akukulanski/RF_Switch_3GHz/Presentación/RF Switch.pptx

## RF Switch

Carducci, Nahuel
Cinetto, Cristian
Demski, Andres
Kukulanski, Ariel
Paunovic, Iván

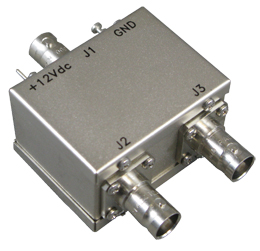
[picture p1: figure]

Medidas Electrónicas 2 - UTN FRBA
13/08/2016

## Índice:

- Descripción del proyecto
- Diodos PIN
- Esquemático
- Simulación
- Desarrollo del PCB

## Descripción del proyecto

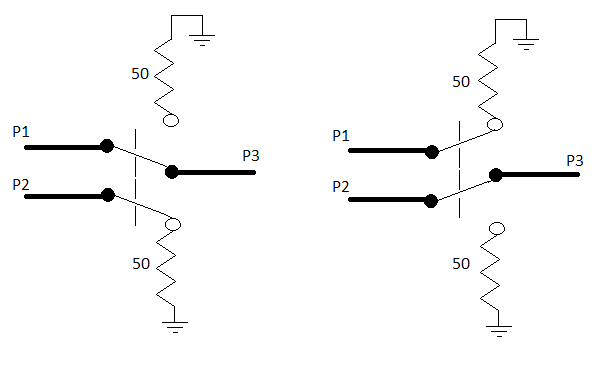
[picture p2: figure]

## Diodos PIN

Curva de Resistencia del diodo pin

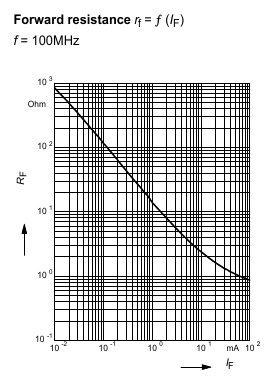
[picture p3: figure]
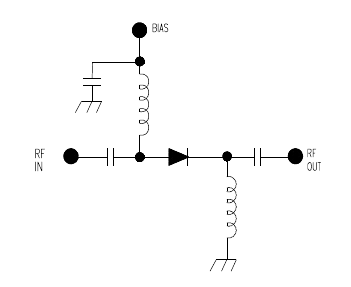
[picture p4: figure]

Circuito de Polarización

## Esquemático

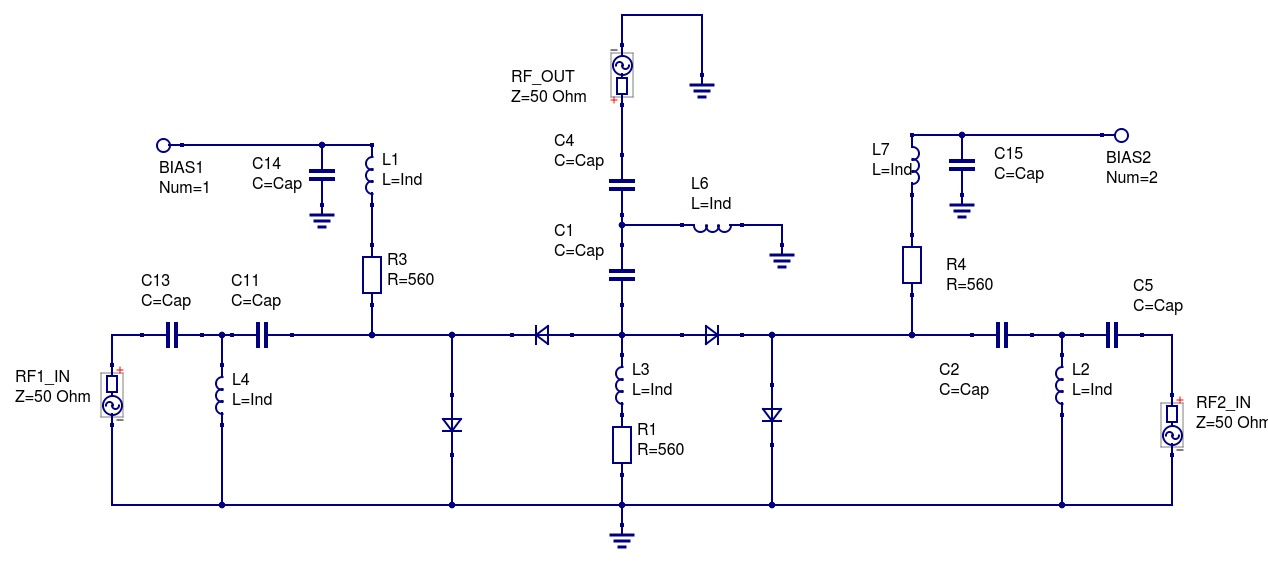
[picture p5: figure]
export

RF IN

50 ohm

RF OUT

## Simulación

Modelo del diodo pin

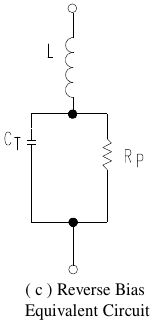
[picture p6: figure]
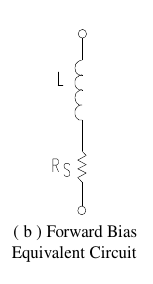
[picture p7: figure]

## Simulación

Valores del diodo PIN BAR64 02V (Infineon)
Rs: 1 ohm ; 50 ohm (polarización)
L: ≈ 1 nHy (despreciable)
Rp: 3 Kohm @ 1.8 Ghz
Ct: 0.17 pF @ 1.8 Ghz

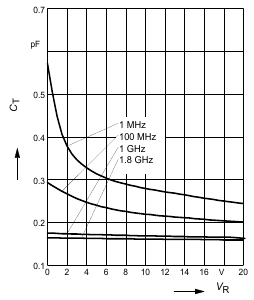
[picture p8: figure]
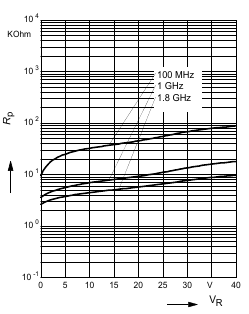
[picture p9: figure]

## Simulación

Resultados:

S11 con puerto 1 desconectado.
Coeficiente de reflexion del puerto que esta desconectado.

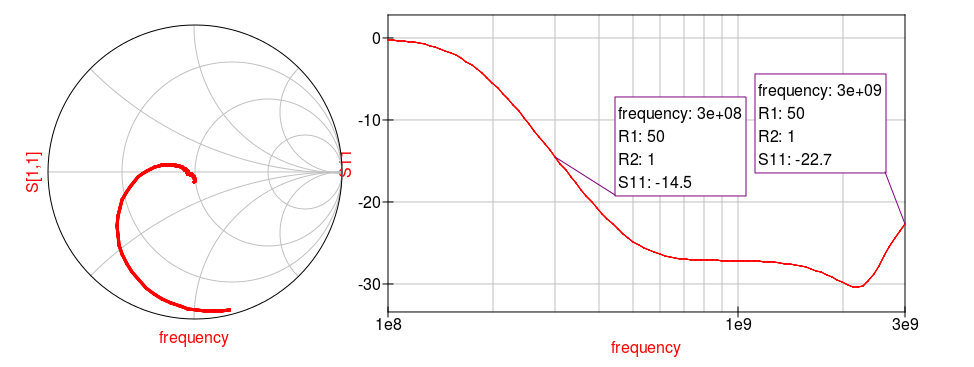
[picture p10: figure]

## Simulación

Resultados:

S22 con puerto 2 conectado.
Coeficiente de reflexion del puerto que esta conectado.

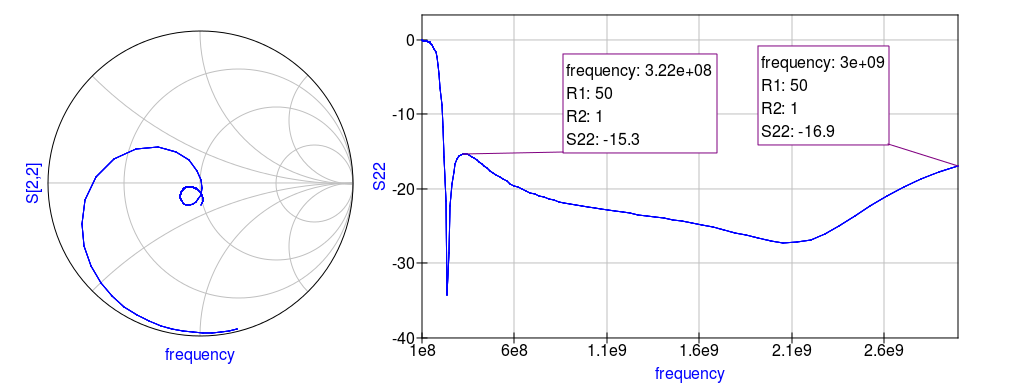
[picture p11: figure]

## Simulación

Resultados:

S31 con puerto 1 desconectado.
Transferencia del puerto que esta desconectado.

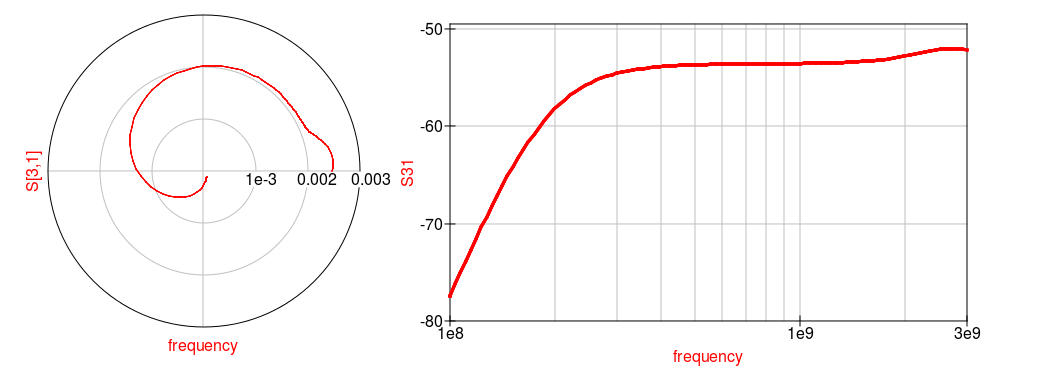
[picture p12: figure]

## Simulación

Resultados:

S23 con puerto 2 conectado.
Transferencia del puerto que esta conectado.

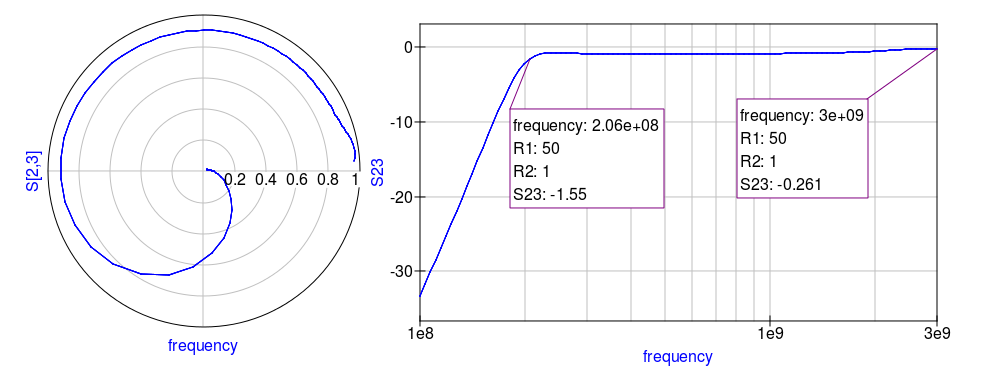
[picture p13: figure]

## Simulación

Resultados:

Coeficiente de reflexion del puerto de salida

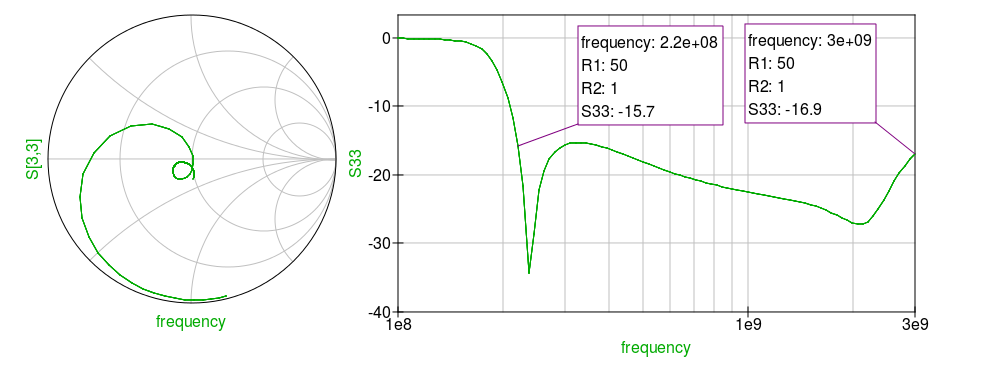
[picture p14: figure]

## Simulación

Resultados:

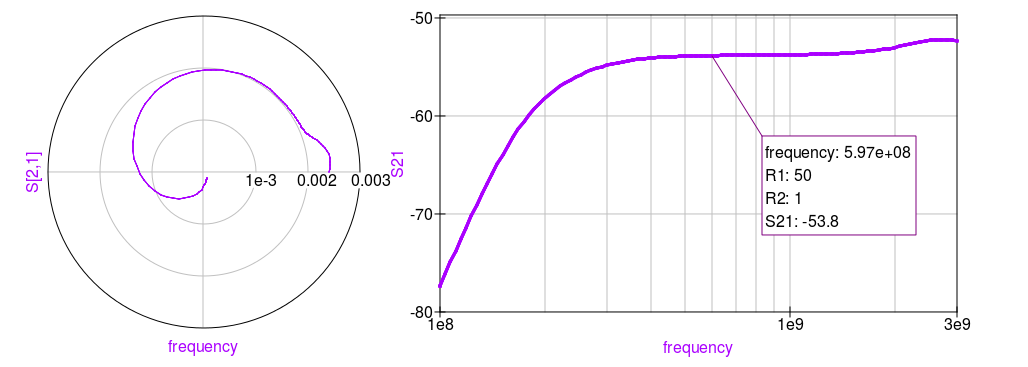
[picture p15: figure]

S21 (Crosstalk)

## Desarrollo PCB-Altium Designer

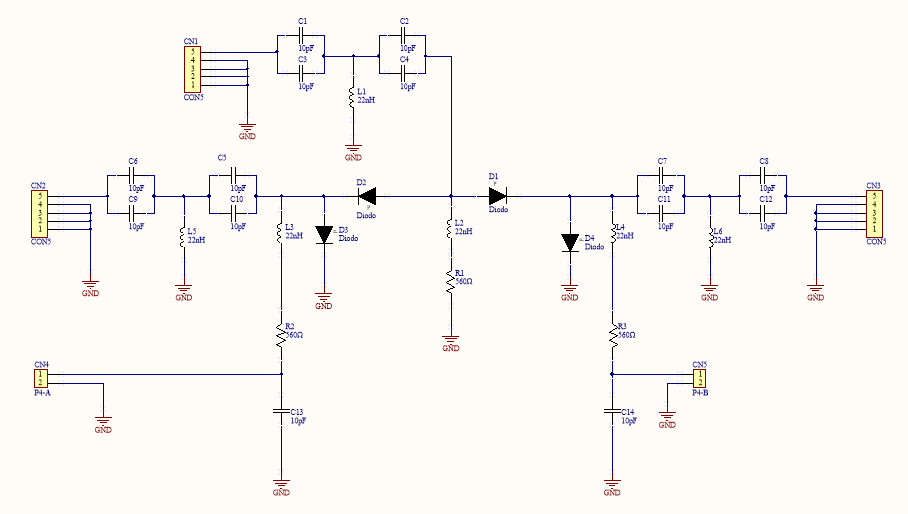
[picture p16: figure]

## Desarrollo PCB-Altium Designer

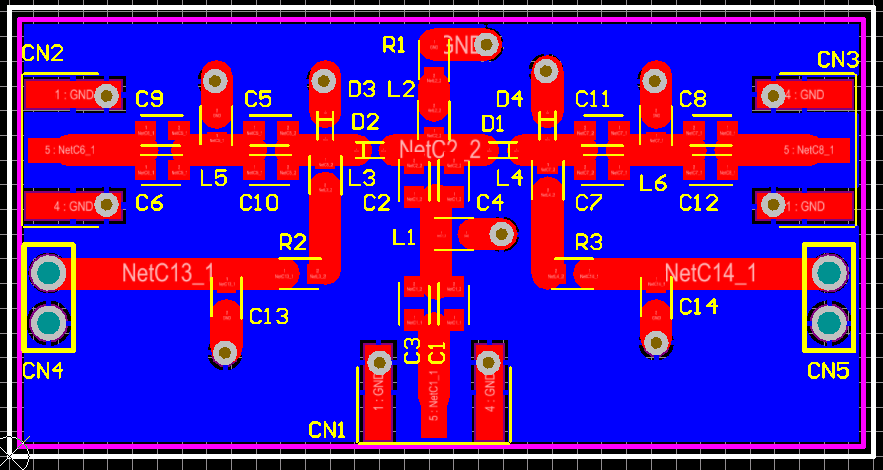
[picture p17: figure]

## Esto es todo amigos!

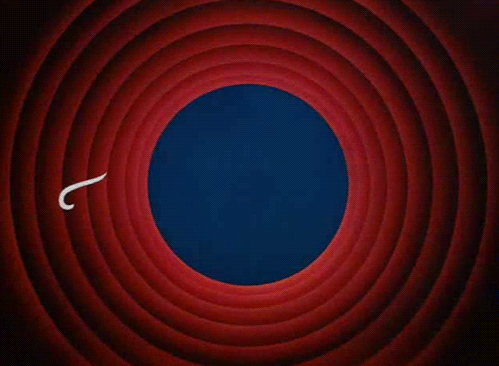
[picture p18: figure]
giphy
