akukulanski/RF_Switch_3GHz/Presentación/informe-rf-switch.pdf

# UNIVERSIDAD TECNOLÓGICA NACIONAL FACULTAD REGIONAL BUENOS AIRES

## Departamento de Electrónica

## Materia: Medidas Electrónicas 2 Proyecto: RF-Switch SPDT con diodos pin

## Docente: Ing. Alejandro Henze

### Ayudante de TP: Ing. Guillermo Monasterios

Grupo N°: 4

Alumnos :

| Apellido y Nombre | Legajo
1 | Carducci, Nahuel | 146.678-1
2 | Cinetto, Cristian | 146.740-2
3 | Demski, Andrés | 146.634-3
4 | Kukulanski, Ariel | 146.771-2
5 | Paunovic, Iván | 146.810-8
Entrega Informe | Fecha | Firma
Primer entrega | 11 / 12 / 16
Aprobación | / / 16
Entrega | Devolución | Re-entrega | Firma Recepción
2° | 15 / 12 / 16 | 16 / 12 / 16
3° | / / 16 | / / 16
4° | / / 16 | / / 16

UTN – FRBA – ME2
Diciembre, 2016

ÍNDICE

Resumen | 2
1. INTRODUCCIÓN | 2
2. DESARROLLO DEL TRABAJO | 3
Principio de funcionamiento | 3
Diseño | 5
Cálculo de la corriente de polarización de los diodos PIN | 5
Diseño del Bias Tee | 5
Diseño de la placa / Layout | 8
Diseño de la fuente de corriente | 10
Modelo matemático | 11
Modelo del diodo pin | 11
Modelo de componentes discretos | 11
Simulaciones | 12
Mediciones Realizadas | 12
Parámetros medidos | 12
Setups de medición utilizados | 13
3. RESULTADOS | 16
4. DISCUSIÓN | 19
5. CONCLUSIONES | 19
6. REFERENCIAS | 19
7. ANEXOS | 21
Tablas con resultados de las mediciones | 21
Señal incidente en puerto 1 - Estado “A” | 21
Señal incidente en puerto 1 - Estado “B” | 22
Señal incidente en puerto 2 - Estado “A” | 23
Señal incidente en puerto 2 - Estado “B” | 24
Señal incidente en puerto 3 - Estado “A” | 25
Señal incidente en puerto 3 - Estado “B” | 26

## RF-Switch SPDT con diodos pin

Carducci N., Cinetto C., Demski A., Kukulanski A. y Paunovic I. Docente a cargo: Henze A., Monasterios G. Universidad Tecnológica Nacional - Facultad Regional Buenos Aires Medidas Electrónicas 2

Resumen
Se diseñó, implementó y caracterizó un switch SPDT disipativo para RF. Para el mismo, se utilizó un circuito basado en diodos PIN, con el cual se obtuvo un ancho de banda del dispositivo de 300 MHz a 3 GHz. El dispositivo fue caracterizado mediante mediciones de parámetros S hechas con un analizador vectorial de redes (VNA) y de su módulo con la utilización de un analizador de espectro (AE).

### 1. INTRODUCCIÓN

Los switches electrónicos tienen varias clasificaciones. En este caso se habla de un switch single pole-double throw (SPDT), lo cual refiere a que un terminal se puede conectar a dos posibles terminaciones distintas (Fig. 1 izq.). En el caso de un double pole - double throw (DPDT) refiere a dos terminales, donde cada uno de ellos puede conectarse en dos terminaciones distintas, y ambas conexiones cambian en forma conjunta (Fig. 1 der.).

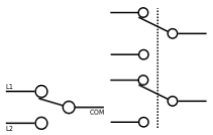
[picture p19: figure]

| Fig. 1: Switch SPDT izquierda, switch DPDT derecha.
| De los switches SPDT, los hay tanto del tipo reflectivo (reflective) y disipativo (absorptive). Los primeros siguen el esquema antes mostrado (Fig. 1 izq.), en el cual el terminal desconectado (L2) queda abierto o en corto, reflejando toda la potencia que se aplique al terminal. En el caso de los disipativos, el puerto desconectado es terminado en la impedancia característica del sistema en el cual esté inmerso (Fig. 2).

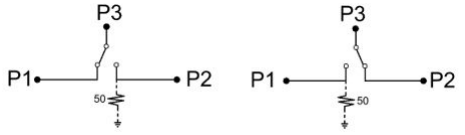
[picture p20: figure]

| Fig. 2: Switch SPDT disipativo.
| También los switches electrónicos pueden clasificarse según la tecnología en que fueron desarrollados. En la Tabla 1 se resumen las características de las principales tecnologías [1]. Este proyecto es realizado utilizando diodos PIN, los cuales al polarizarlos en directa funcionan para RF como una resistencia cuyo valor es controlable con la corriente de polarización, y al ponerlos en inversa

presentan una impedancia alta.

| Basados en diodos PINs | Basados en FETs | Electromecánicos o MEMS
Aislación en alta frecuencia | Mala | Mala | Buena
Frecuencia de corte inferior | ~ 10MHz | Muy baja | Desde DC
Potencia | Alta | Media | Alta
Respuesta | No lineal en bajas frecuencias | Lineal | Muy lineal
Velocidad de conmutación | Rápida | Rápida | Lenta
Consumo de polarización | Alto | Bajo | _
Insertion loss | Medio | Medio | Muy bajo
Redes de polarización | Complejas | Sencillas | No tiene
Ciclos de vida | Alto | Alto | Medio
| Tabla 1: Comparativa de las distintas tecnologías switches.

### 2. DESARROLLO DEL TRABAJO

| Principio de funcionamiento
| El funcionamiento de este switch se basa en la polarización de cuatro diodos PIN (Fig. 3) [2], de forma de obtener dos estados posibles. Uno en el cual el puerto 1 queda conectado al puerto 3, con el puerto 2 presentando la impedancia característica de 50Ω, y el otro en el cual el puerto 2 se conecta al puerto 3, y es el puerto 1 el que presenta 50Ω.

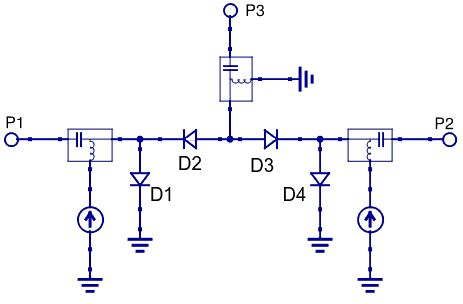
[picture p21: figure]

| Fig. 3: Esquema básico de un SPDT con diodos pin.

Los diodos PIN están formados por tres capas. Una dopada tipo N, una intrínseca, y una dopada tipo P. Tienen la particularidad que al circular por ellos una corriente continua, se acumulan portadores en la capa intrínseca. A partir de cierta frecuencia, la capa intrínseca no llega a desagotarse de portadores, por lo que presenta un comportamiento resistivo. La magnitud de la corriente continua que circule está fuertemente ligada a la cantidad de portadores acumulados, y por lo tanto, a la resistencia que presenta el dispositivo en alta frecuencia. Esta relación se puede ver en la curva que se presenta en la Fig. 4, la cual es parte de la hoja de datos del diodo PIN BAR64-02V [3].
Para polarizar los diodos y al mismo tiempo hacerles circular la RF, es necesario desacoplar las bajas y altas frecuencias entre sí. Esto se logra con un Bias-Tee. El Bias-Tee es una red de tres puertos (RF, CC, RF+CC) que permite aislar entre sí los puertos de señal (RF) y corriente continua (CC). El esquema más básico consiste en un inductor y un capacitor de acople (Fig. 5). El capacitor funciona como un cortocircuito para la señal de RF, y un circuito abierto para la continua, mientras que el inductor funciona como circuito abierto para la RF, y como cortocircuito para la continua.

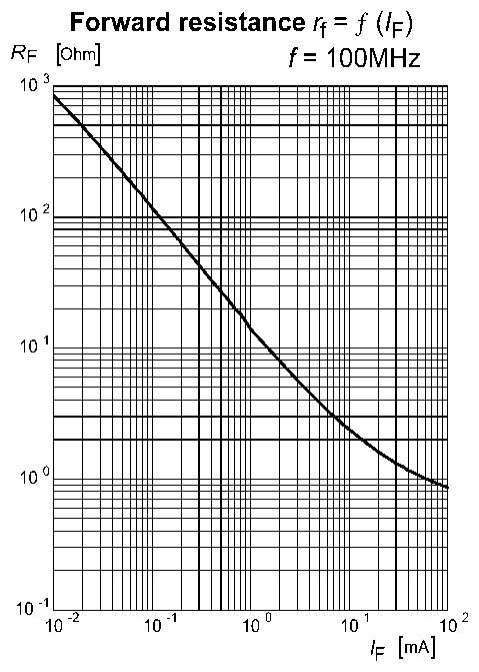
[picture p22: figure]

| Fig. 4: Curva de Resistencia vs Corriente del diodo PIN BAR64-02V [3].

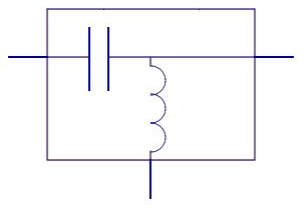
[picture p23: figure]

| Fig. 5: Bias-Tee.
| El primer caso (P1 conectado a P3) se logra polarizando el diodo que une los puertos 1 y 3 (D2) de forma que presente una resistencia lo más baja posible. Los diodos D1 y D3 deben quedar en inversa para conseguir una resistencia lo maś alta posible. El diodo D4 es en este caso el encargado de presentar los

50Ω al puerto 2. El segundo caso (P2 conectado a P3) se logra invirtiendo los roles entre D2 y D3, y entre D1 y D4.

Diseño
Cálculo de la corriente de polarización de los diodos PIN
Para el diseño se utiliza el diodo BAR64-02V. De su curva de resistencia en función de la corriente directa (Fig. 4), se obtienen los valores de corriente con los que se logran las condiciones planteadas anteriormente.
Para obtener un bajo Insertion Loss, se elige una corriente de 20 mA, con la cual la resistencia en alta frecuencia es de 1,3 Ω. Para lograr una resistencia de 50 Ω, la corriente directa es de 250 µA. Para establecer una alta aislación, basta con polarizar el diodo en inversa. Se observa que la resistencia en inversa está siempre por encima de 2,5 KΩ (Fig. 6), suficiente para el diseño que se plantea.

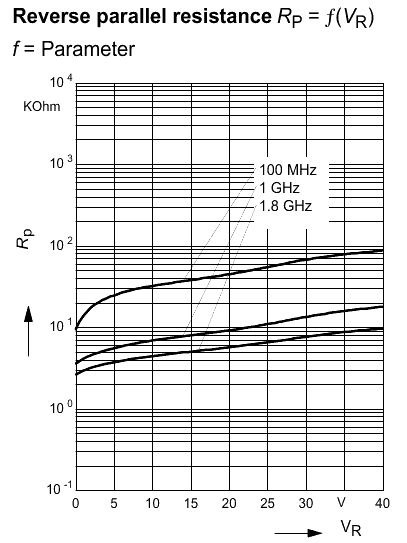
[picture p24: figure]

| Fig. 6: Resistencia del diodo BAR64-02V en función de su tensión inversa [3].
| Diseño del Bias Tee
| Para un correcto funcionamiento, el puerto de RF debe presentar una impedancia baja en la banda de funcionamiento del dispositivo, y una alta en continua. Como primera aproximación, si se quiere una reactancia capacitiva menor a 1 Ω a 300MHz, la capacidad deberá ser mayor a 530 pF. Y si se quiere una reactancia inductiva de al menos 1 KΩ a esa misma frecuencia, el inductor será como mínimo de 530 nH. Estos valores son factibles para anchos de banda no muy grandes, pero si se busca que sea de al menos una década (300 MHz a 3 GHz), resulta complicado conseguir componentes que tengan una frecuencia de autoresonancia mayor a los 3 GHz. Por ejemplo, el inductor LQW18ANR47J00D de Murata [5] tiene un valor de 470 nH, pero su frecuencia de resonancia es de 700 MHz. Ante esta situación se resuelve, en vez de usar un único inductor, utilizar varios de distintos valores en cascada, a los que se les reduce el factor de mérito por medio de una resistencia en paralelo, de forma de mantener un valor de impedancia mínimo en la banda de trabajo del switch. Utilizando TINA® como herramienta de simulación, se obtuvieron las impedancias para distintas configuraciones posibles, utilizando como modelo del inductor un tanque LC paralelo que contempla la capacidad parásita. En la Fig. 7 se muestra el módulo y la fase de la impedancia para un inductor de 470 nH que resuena a 700 MHz (violeta), y uno de 22 nH que resuena a 3 GHz (azul). El inductor de 470 nH sólo no sirve, por tener una reactancia capacitiva a partir de los 700 MHz. El inductor de 22 nH sólo tampoco sirve, por tener una muy baja impedancia en frecuencias por debajo de 1 GHz. Si se conecta ambos inductores en serie, existe una zona en donde la reactancia inductiva del de 22 nH se anulará con la reactancia capacitiva del de 470 nH, generando un valle en el módulo de impedancia. La solución es empeorar el factor de calidad de ambos inductores, forzando que la impedancia cerca de la resonancia esté dominada por el elemento resistivo agregado [4]. El efecto de las resistencias se muestra en la Fig. 8, en donde se grafica la impedancia de los dos inductores mencionados en serie sin resistencias adicionales (marrón), y con resistencias de 1 KΩ en paralelo a cada uno (verde). Se observa que agregando las resistencias, entre 300 MHz y 3 GHz se mantiene una impedancia por encima de 500 Ω, siendo esta inductiva entre 300 MHz y 700 MHz, y predominantemente resistiva (o ligeramente capacitiva) entre 700 MHz y 3 GHz.

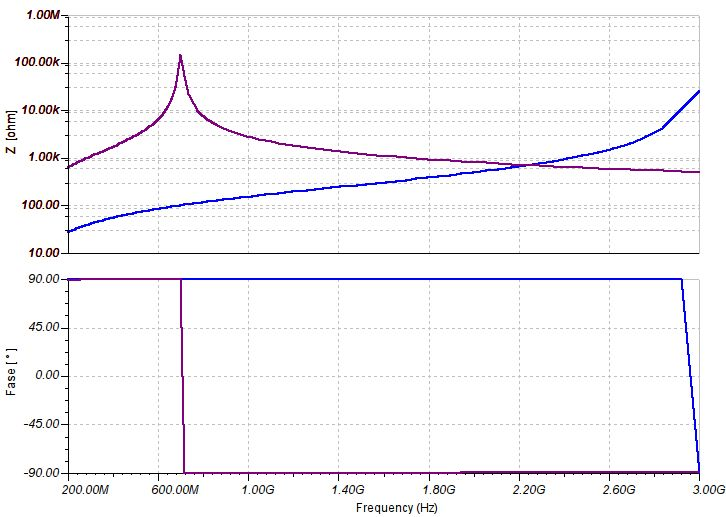
[picture p25: figure]

| Fig. 7: Impedancia de inductor de 470 nH con resonancia en 700 MHz (violeta) y de inductor de 22 nH con resonancia en 3 GHz (azul)

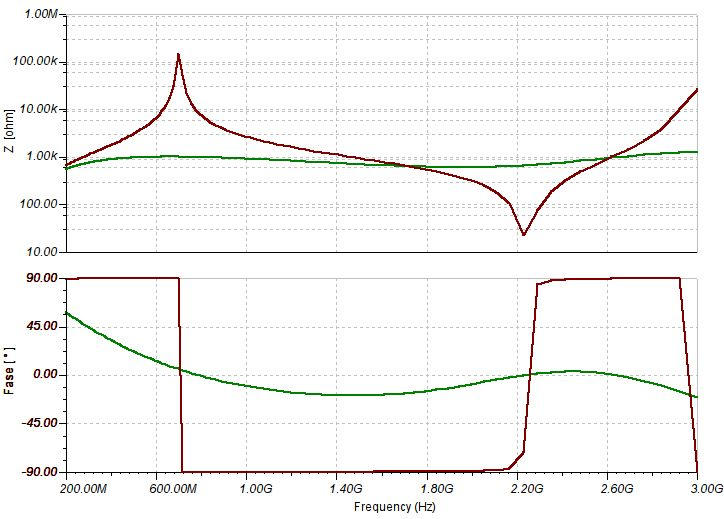
[picture p26: figure]

| Fig. 8: Impedancia de inductores de 470 nH y 22 nH en serie sin (marrón) y con (verde) resistencias de 1 KΩ en paralelo a cada uno.
| Para evitar la autoresonancia de los componentes antes de los 3 GHz, se basa el diseño en capacitores de 10 pF, en lugar de los 530 pF planteados originalmente. Dada su baja reactancia a 300 MHz, se utilizan de a pares conectados en paralelo, formando 20 pF. Dado que los 20 pF siguen teniendo una respuesta mala en 300 MHz (reactancia de 26,5 Ω), se procede a realizar un filtro que mejora la adaptación, utilizando los componentes disponibles. El filtro es un pasaaltos que consta de dos capacidades y una inductancia, dispuestos en forma “T” como se muestra en la figura 9 (b). La respuesta del filtro se obtuvo a partir de una simulación con QUCS y se muestra en la figura 10, donde se lo compara con la del capacitor sólo.

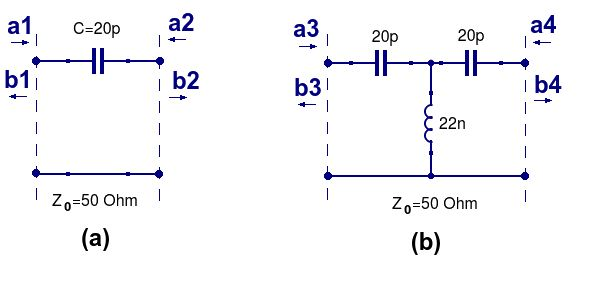
[picture p27: figure]

| Fig. 9: (a) acople con capacitor de 20 pF. (b) acople con filtro T

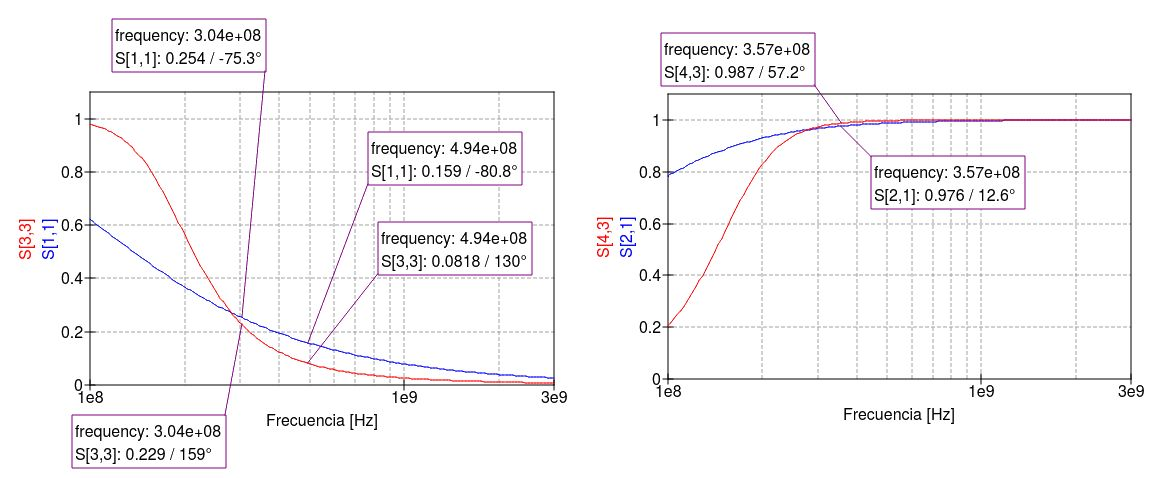
[picture p28: figure]

| Fig. 10: Parámetro de reflexión (a) y de transmisión (b) para ambos acoples. En azul los parámetros con el capacitor, y en rojo los parámetros con el filtro T.
| Diseño de la placa / Layout
| Para el diseño del circuito impreso se debe tener en cuenta el ancho de la traza para evitar desadaptaciones. En baja frecuencia esto no es un problema pero en alta frecuencia, donde la longitud de onda tiene un valor más cercano a las dimensiones de la pista, es importante que la impedancia característica de la línea sea lo más cercana posible a la del generador y la carga para disminuir las reflexiones y así bajar la ROE. La impedancia característica de la línea depende de varios factores, como el ancho de la traza, el espesor del sustrato utilizado para hacer el pcb y su permeabilidad eléctrica. La placa se realizó utilizando un sustrato RO4350B™ [6] de un espesor de 0,76mm. Para el ruteo se optó por una línea tipo microstrip con impedancia característica de 50 Ω (Fig. 11).

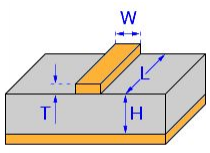
[picture p29: figure]

| Fig. 11: Esquema de un microstrip [QUCS].
| Para conseguir esta impedancia el ancho de la pista fue de 1.63mm , valor que fue verificado con TX-LINE y QUCS. Además de elegir el ancho de la traza, se tuvo en consideración lo siguiente:
| ● Se hizo la placa lo más chica posible ● Se utilizaron componentes 0603 para las resistencias, capacitores e inductores ● Se utilizaron 3 conectores SMA para las dos entradas y la salida de la señal ● Se utilizaron diodos PIN con encapsulado SC79 (su tamaño es de aproximadamente 1.6mm x

0.85mm)
| ● Se utilizó un conector con pines hembra para conectar las fuentes de polarización ● Se hizo un plano de masa por debajo del PCB y se agregaron vías para hacer contacto directo con

el plano de masa
| ● Las trazas se hicieron lo más rectas posible, sin curvatura

La placa finalizada se muestra en la Fig. 12 donde se puede apreciar el signal path recto entre los puertos P1 y P2, y el camino a 90° en forma de “L” entre los puertos P1-P3 y P2-P3. También se observa un conector de pines hembra para conectar las fuentes de polarización.

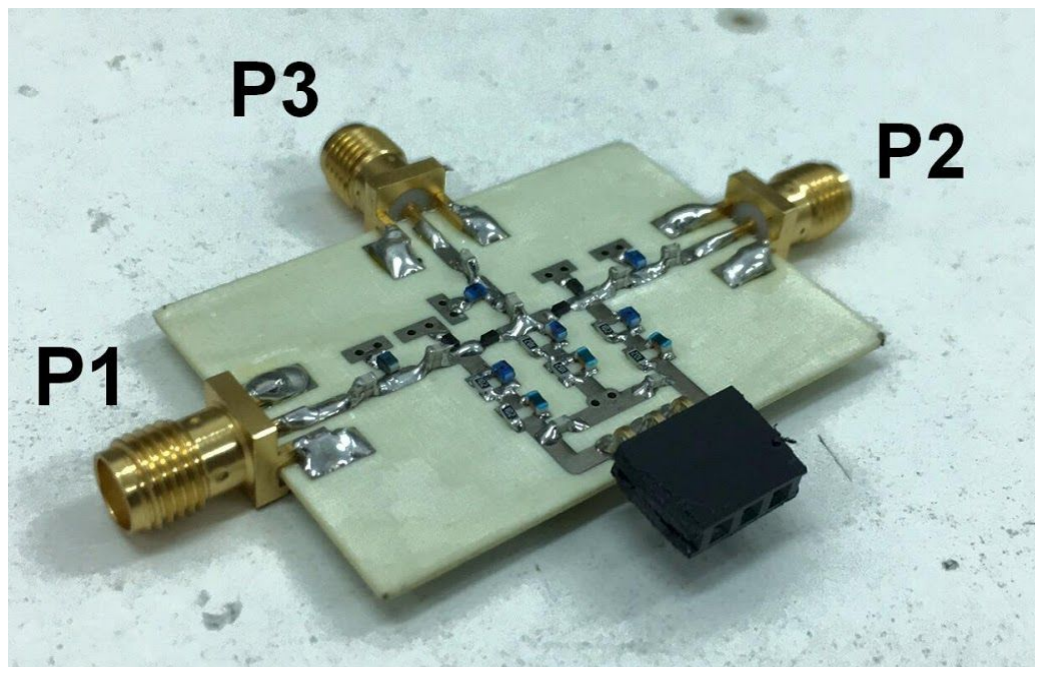
[picture p30: figure]
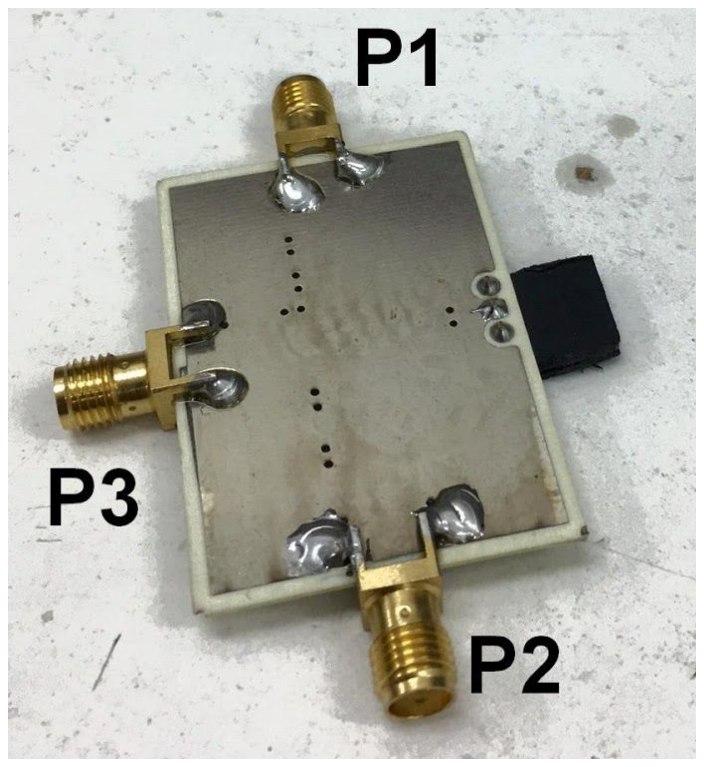
[picture p31: figure]

| Fig. 12: Fotos de la placa finalizada.
| Los componentes utilizados se encuentran en la Tabla 2.

cant | | Marca / Código | Características relevantes
3 | Conector SMA hembra | RS Pro - R19-070-01-0032210LL [7] | 0~18 GHz,
3 | Inductor 470 nH | Murata - LQW18ANR47J00D [5] | f0 = 700 MHz
6 | Inductor 22 nH | TE Connectivity - 36501J22NJTDG [8] | f0 =3 GHz
14 | Capacitor 10 pF | Kemet - C0603C100J5GACTU [9] | Encapsulado 0603, Dieléctrico C0G
6 | Resistor 1 KΩ | - sin datos - | Encapsulado 0603
4 | Diodo PIN | Infineon BAR 64-02V [3] | 1 MHz~6GHz
| Tabla 2: Componentes utilizados

Diseño de la fuente de corriente
| Para polarizar el dispositivo, se realizó un circuito que consiste en dos fuentes de corrientes, las cuales se conmutan manualmente mediante una llave. Como se menciona anteriormente, se usa una corriente de 20 mA para obtener una baja resistencia, y una de 250 µA para obtener 50 Ω. En la figura 13 se muestra el circuito equivalente de DC, polarizado para conectar el puerto 1 al 3, y presentando 50 Ω en el puerto 2. Se observa que para polarizar el diodo D2 con 20 mA, es necesario un potencial Va menor al de masa, dejando a D1 en inversa. Lo mismo ocurre con D3 y D4: para hacer circular corriente por D4, el potencial Vb será mayor a masa, dejando a D3 en inversa. Esto permite polarizar los diodos utilizando sólo dos fuentes de corriente. La conmutación del switch se logra conmutando las fuentes

de corriente.

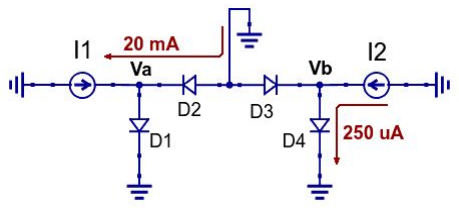
[picture p32: figure]

| Fig. 13: Circuito equivalente de continua.
| La implementación de las fuentes de corriente se encuentran en la Fig. 14. La fuente de 20 mA se realizó con el MOSFET canal N 2N7000 en el cual, mediante un regulador de tensión y un preset, se puede ajustar la corriente de drenaje. La fuente de 250 µA se realizó con dos transistores pnp BC327 en configuración espejo con emisor degenerado. También se fija la corriente por medio de un regulador de

tensión y un preset.

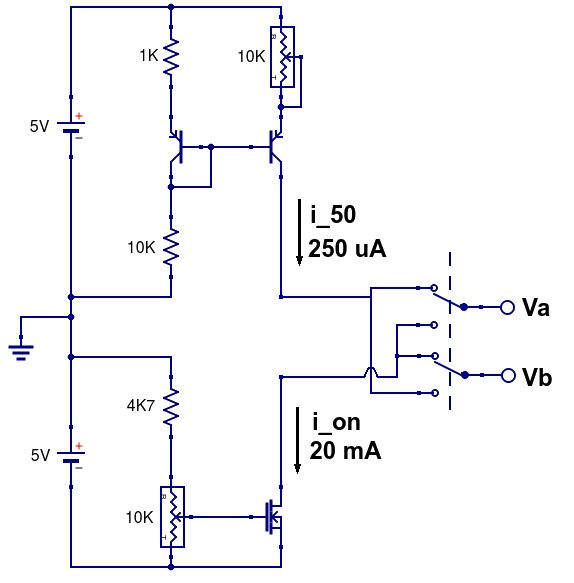
[picture p33: figure]

| Fig. 14: Fuentes de corriente para polarizar los diodos PIN.

Modelo matemático
Modelo del diodo pin
| El modelo del diodo pin en alta frecuencia consiste en una resistencia en paralelo con un capacitor. Al polarizarlo en directa, la resistencia es lo suficientemente baja como para despreciar la capacidad. Los modelos equivalentes para las distintas polarizaciones se muestran en la figura 15.

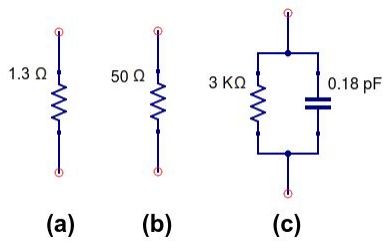
[picture p34: figure]

| Fig. 15: Modelo equivalente del diodo pin en alta frecuencia polarizado en directa con (a) 20 mA, (b) en directa con 250 µA y (c) en inversa.
| Modelo de componentes discretos
| Los resistores y capacitores se asumen ideales por no tener una hoja de datos para modelizarlos. Los inductores, en cambio, se los modeliza con su capacidad paralela parásita, responsable de la autorresonancia del componente. El inductor de 22 nH resuena en 3 GHz, y el de 470 nH en 700 MHz. Los modelos equivalentes de los inductores se muestran en la Fig. 16.

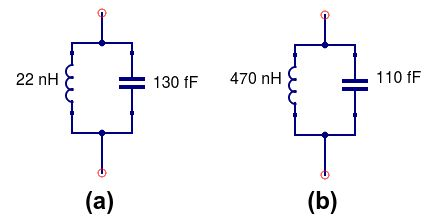
[picture p35: figure]

| Fig. 16: Modelo equivalente de inductor de (a) 22 nH y (b) 470 nH.

Simulaciones
| Se realizaron simulaciones de los parámetros S con el programa QUCS. En este se tuvieron en consideración los modelos aclarados en la sección anterior. El circuito completo simulado se encuentra en la

Fig. 17. Los resultados de los parámetros simulados se encuentran junto a las mediciones para poder compararlas.

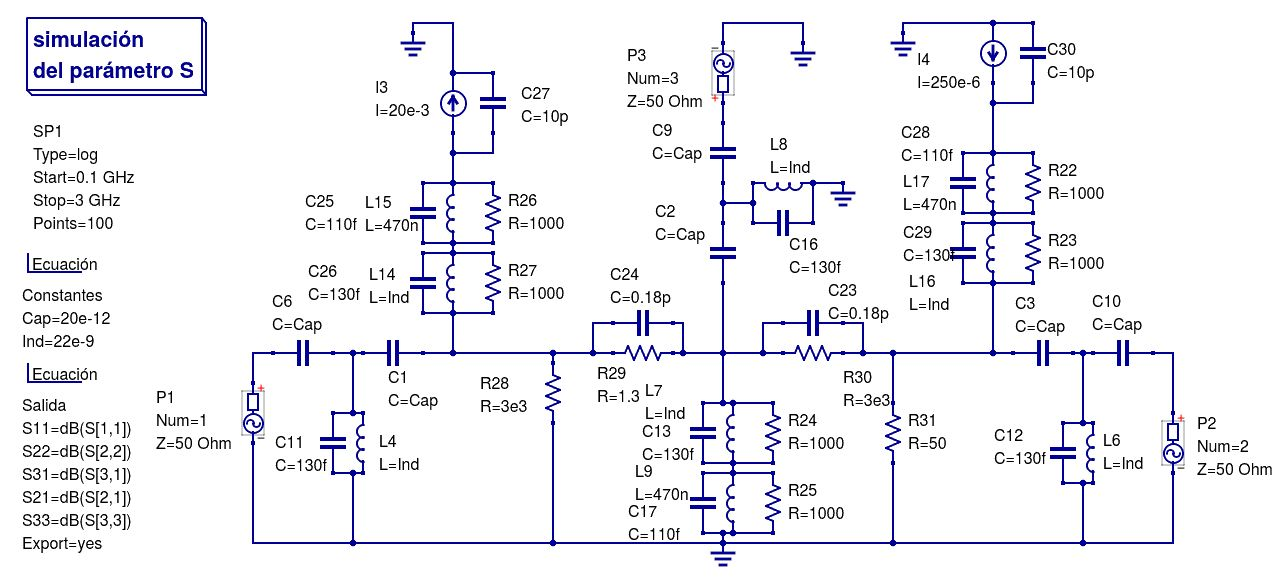
[picture p36: figure]

| Fig. 17: Circuito simulado

Mediciones Realizadas
Parámetros medidos
| Por ser una red de tres puertos, la matriz de parámetros Scattering que caracteriza el switch es de 3x3. A esto se le suma el hecho de que tiene dos estados posibles según a qué puerto se haya conectado el puerto 3, a los que se referirá en el informe como estado “A” y estado “B”. El estado “A” corresponde a conectar el puerto 1 con el 3, y cargar el puerto 2 con 50 Ω, mientras que el estado “B” corresponde a conectar el puerto 2 con el 3, y cargar el puerto 1 con 50 Ω. Para una caracterización completa, la medición consiste en la obtención de 18 parámetros (9 para cada estado posible), tal como se muestra en la Fig. 18.

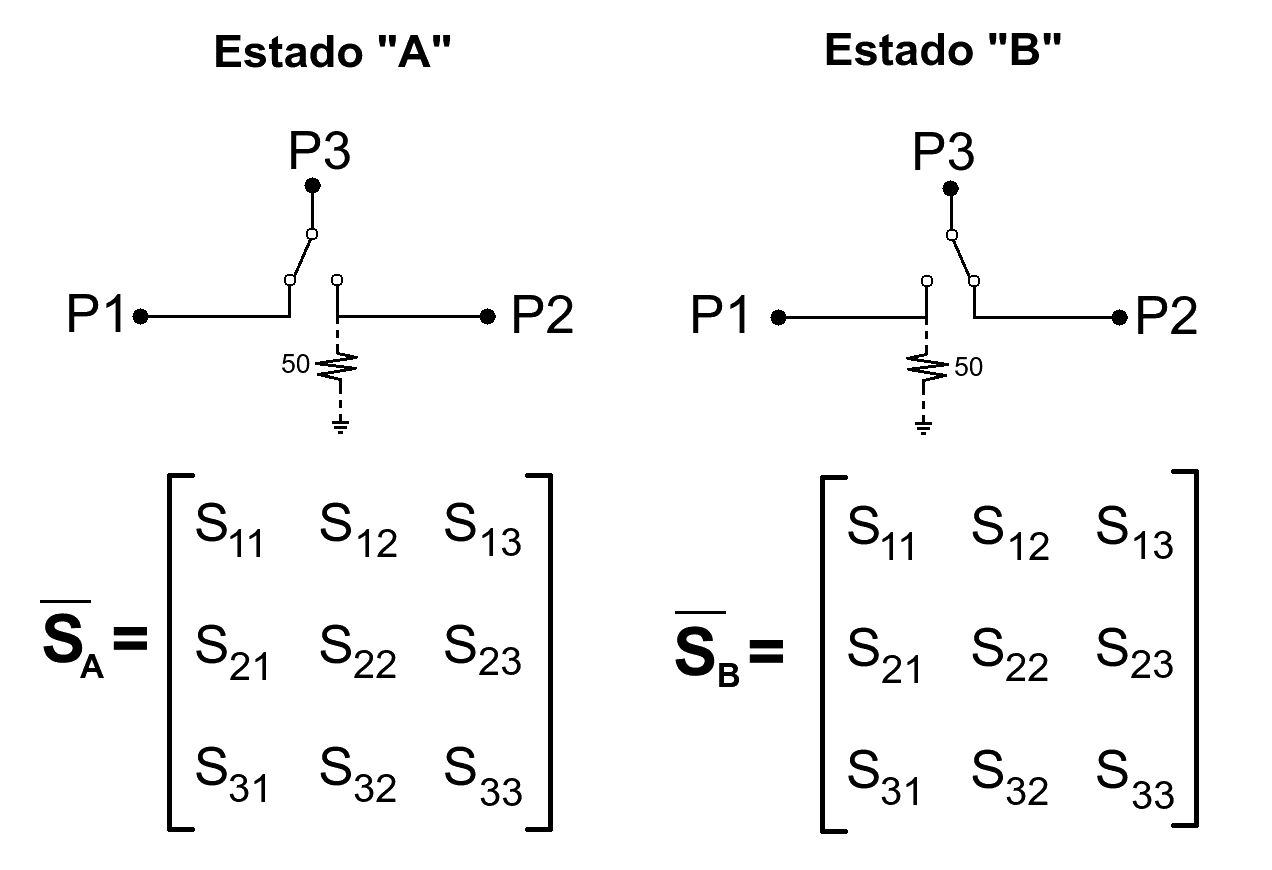
[picture p37: figure]

| Fig. 18: Matrices S para los estados “A” y “B” del switch
| Por ser muy extensa, la información completa de las mediciones se encuentra en el anexo donde, además, se la compara con los valores simulados.
| Setups de medición utilizados
| Las mediciones de los parámetros S del dispositivo se realizaron con dos setups distintos. El primer setup de medición es el VNA que se encuentra en la facultad, realizado con instrumentos de laboratorio comunes [10] (Fig. 19). En este setup (Fig. 20) la señal es aplicada con un generador de RF (Agilent N9310A), la cual con un power splitter es dividida, parte a un canal del osciloscopio (Agilent DSO9254A) donde se mide la onda incidente y parte a la entrada de un acoplador direccional (Agilent 86205A). La salida del acoplador direccional se conecta al DUT, y la salida del acoplador con la onda reflejada es amplificada y conectada a un segundo canal del osciloscopio. La salida del DUT se la conecta al tercer canal del osciloscopio. Se usa un modelo de corrección de errores One Path - Two Ports . Se realizaron mediciones de los parámetros en dos días distintos, haciendo en cada una de ellas la respectiva calibración. En la primera de ellas se aplicó un nivel de señal algo bajo (0 dBm), y no se lograron medir parámetros como crosstalk y aislación debido al rango dinámico limitado del osciloscopio. En la segunda medición, se aplicó una señal de 13 dBm, y se lo pudo medir correctamente.

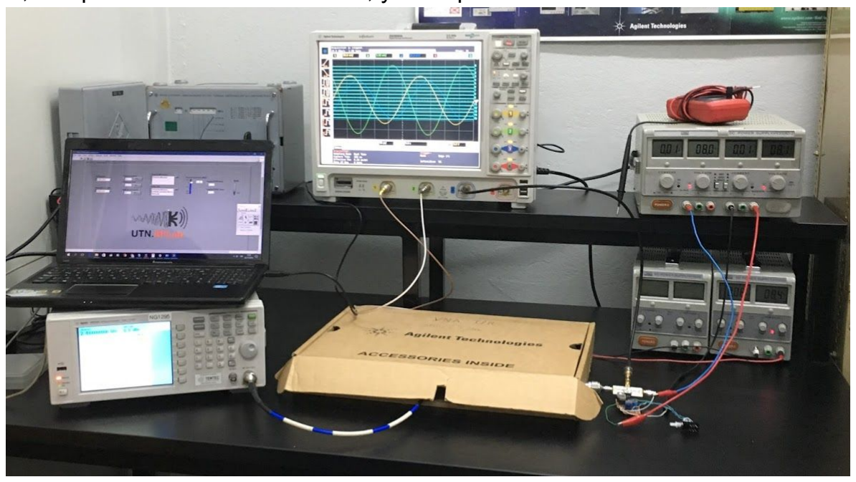
[picture p38: figure]

| Fig. 19: Setup de la medición realizada con VNA.

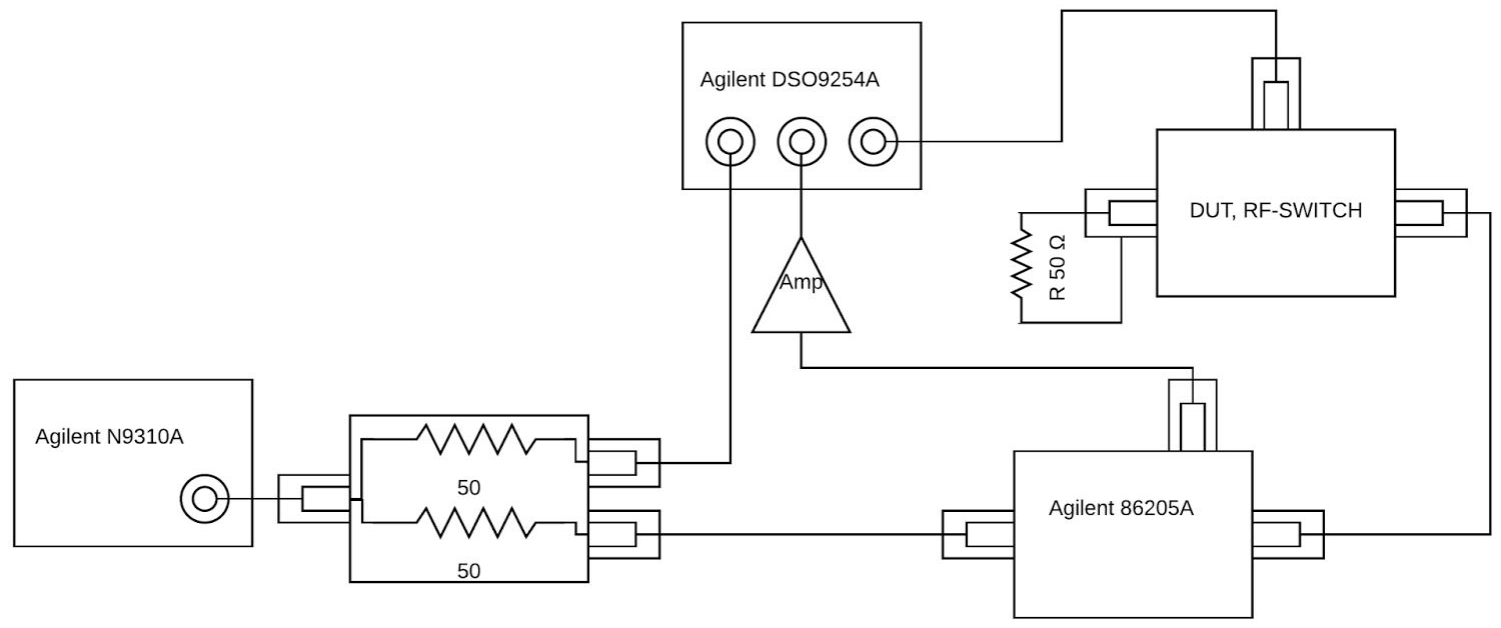
[picture p39: figure]

| Fig. 20: Diagrama en bloques del setup medición con VNA.
| El segundo setup utilizado permite medir el módulo de los parámetros S del sistema (Fig. 21). Este consiste de un analizador de espectro (Agilent N9320A) y un acoplador direccional (Agilent 778D), utilizándose además el tracking generator del primero. El setup tiene dos configuraciones, según se miden parámetros de transmisión o de reflexión. En el primer caso (Fig. 22) se aplica señal con el tracking generator en el puerto de entrada del DUT y se mide en el puerto usado como salida. Para calibrar, se realiza primero un through y se normaliza la escala del AE respecto a esta medición. En el segundo caso (Fig. 23), se aplica señal con el tracking generator a la entrada acoplador direccional, la salida de este se conecta al puerto usado como entrada del DUT, y la salida que acopla la reflejada se conecta a la entrada AE. Para calibrar, se usa un cortocircuito y un circuito abierto conectados en el lugar del DUT, los cuales producen una reflexión total pero con fases contrarias. Las curvas medidas por el AE fueron exportadas en ambos casos, y se utiliza el promedio de ambas como curva de normalización (Fig. 24).

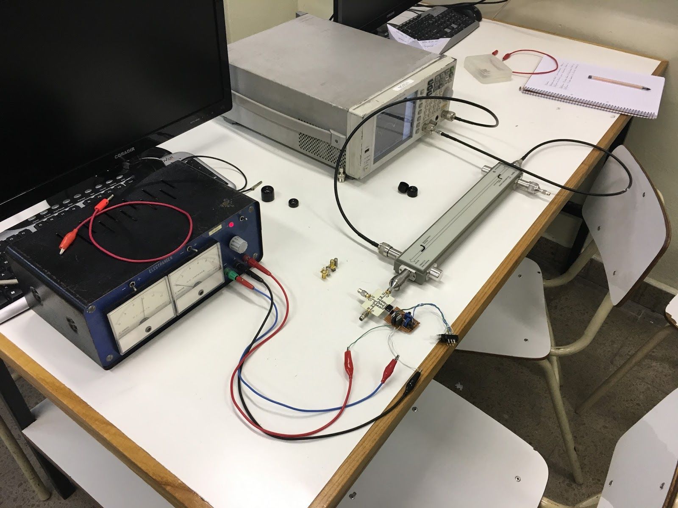
[picture p40: figure]

| Fig. 21: Setup de medición con AE y acoplador direccional.

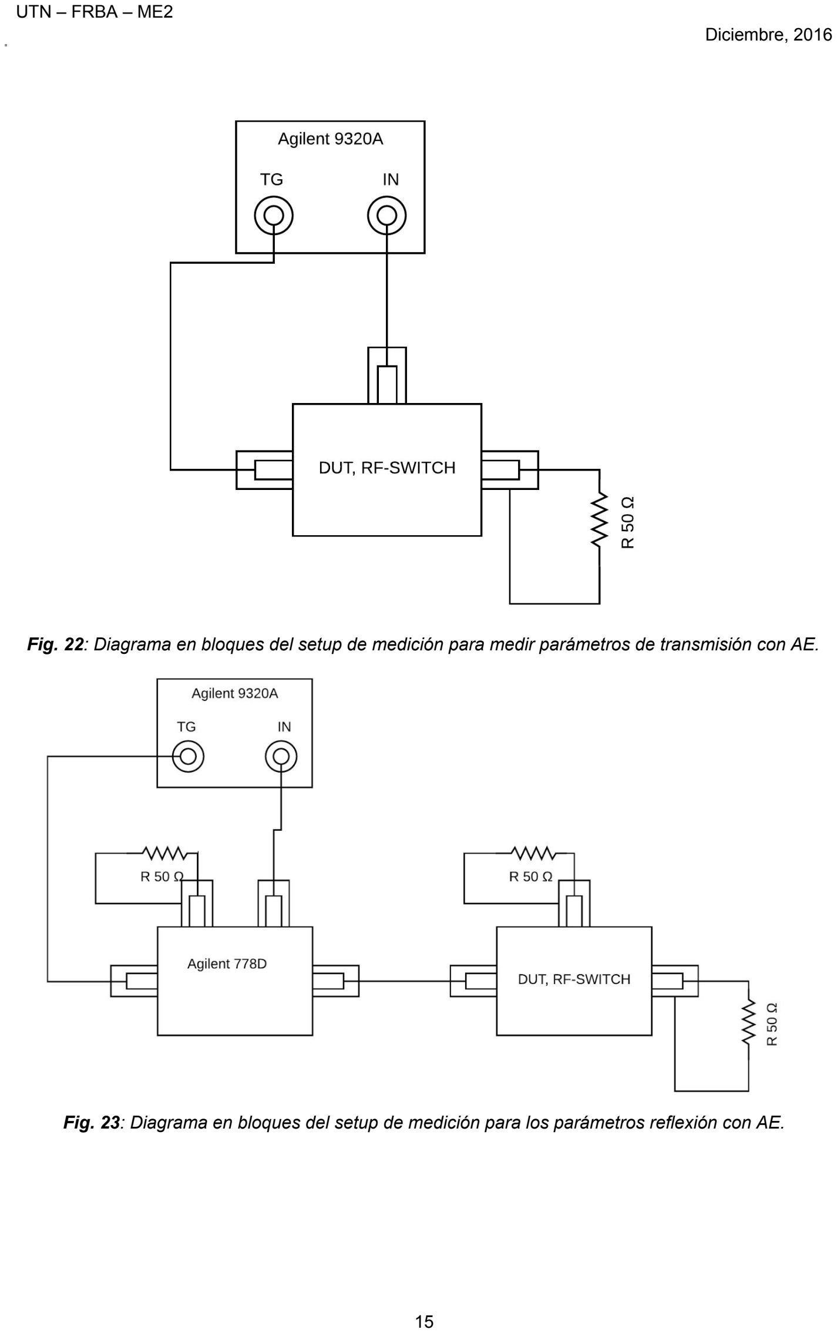
[picture p41: page 16]

| Fig. 22: Diagrama en bloques del setup de medición para medir parámetros de transmisión con AE.
| Fig. 23: Diagrama en bloques del setup de medición para los parámetros reflexión con AE.

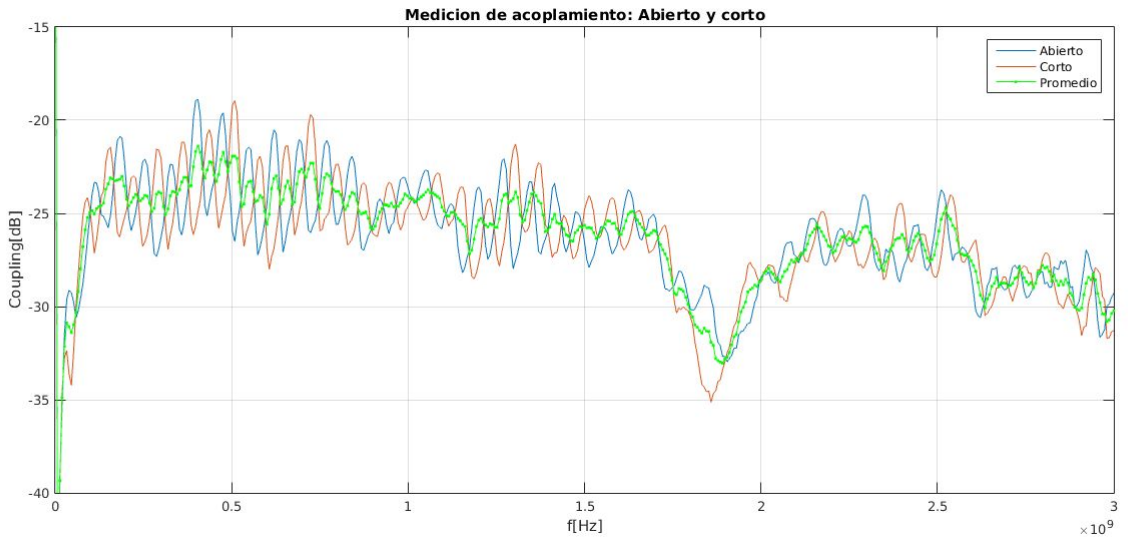
[picture p42: figure]

| Fig. 24: Resultado de la medición del acoplamiento con cortocircuito y circuito abierto

### 3. RESULTADOS

| En esta sección se presentan los gráficos más relevantes de los resultados de las mediciones realizadas junto con los de las simulaciones, para poder analizarlos y compararlos. Se omiten gráficos que aportan poca información adicional debido a la simetría del circuito, resultando en curvas similares. En la Fig. 25 se muestra el parámetro de reflexión S11 para los estados “A” (P1 → P3) y “B” (P2 → P3). En este caso la medición con el VNA se obtuvo con una señal de entrada de 13 dBm. Se observa que para ambos casos, lo medido con el analizador de espectro y con el VNA es similar, y difiere tanto en valores como en morfología respecto a lo simulado. El peor caso dentro del rango de trabajo (300 MHz ~ 3 GHz) se encuentra en 1,2 GHz, donde el módulo de S11 está cerca de -10 dB, repitiéndose esta situación al acercarse a la frecuencia máxima de trabajo. Es útil aclarar que las mediciones de S22 para estos mismos estados dan resultados similares, algo esperable dada la simetría existente en el circuito.

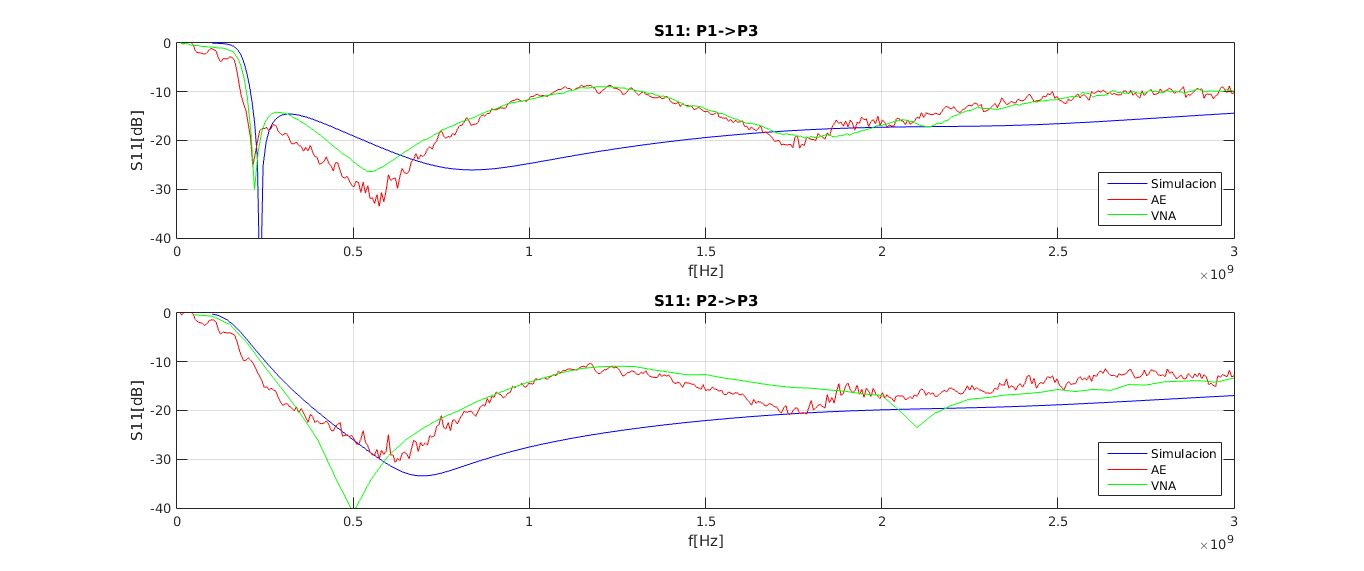
[picture p43: figure]

| Fig. 25: S11 simulado (azul), medido con VNA (verde) y medido con AE (rojo) para los estados “A” (arriba) y “B” (abajo).
| En la Fig. 26 se muestra el parámetro S31. En el estado “A” S31 es considerado un parámetro de transmisión, por lo que se busca que sea lo más cercano a 0 dB, es decir, que transmita el 100% de la señal. En el estado “B”, por el contrario, es un parámetro de aislación, por lo que se busca que no transmita. Se observa que el resultado de la medición con VNA en el estado “A” es muy parecido al simulado, excepto por un valle que aparece entre 800 MHz y 1,4 GHz. En el estado “B” se observa que los resultados de las mediciones copian a los simulados, excepto por el valle que aparece nuevamente. La aislación cae (sube S31) al subir la frecuencia debido principalmente a la capacidad parásita del diodo PIN. Por ser recíproco, estos valores resultan similares a los de S13. Además, por la simetría del circuito, también son parecidos a S32 y S23 (invirtiéndose entre sí los resultados de los estados “A” y “B”).

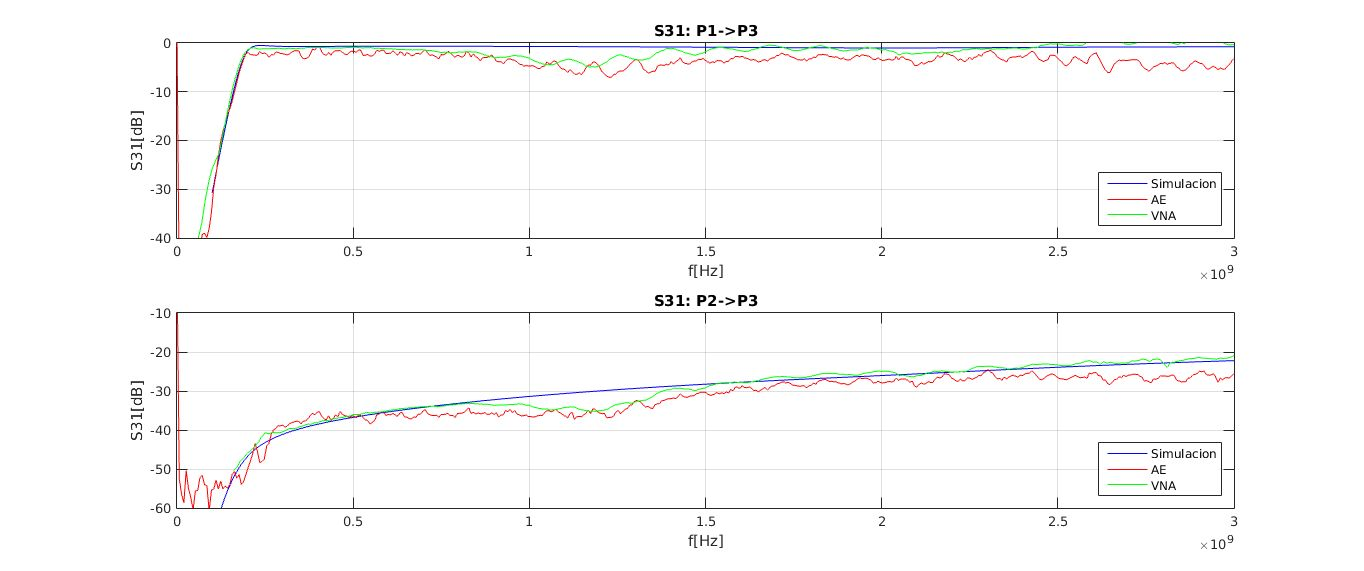
[picture p44: figure]

| Fig. 26: S31 simulado (azul), medido con VNA (verde) y medido con AE (rojo) para los estados “A” (arriba) y “B” (abajo).
| En la Fig. 27 se muestra el parámetro S21 en estado “A”. De cualquier forma, no se hace gran distinción entre los estados “A” y “B” debido a que la conmutación entre puertos 1 y 2 sólo invierte el orden de los componentes, pero no varía el circuito de transmisión entre ambos puertos. Este es un parámetro conocido como crosstalk, y debe ser lo más bajo posible. Sólo fue medido con el analizador de espectro debido al rango dinámico limitado del VNA y a la baja potencia de entrada aplicada al sistema (0dBm). El resultado de la medición es una curva que copia a la simulada, excepto por el valle cerca de 1,2 GHz. Se respeta el carácter creciente con la frecuencia obtenido de la simulación. Los parámetros S12(“A”), S21(“B) y S12(“B”) dan resultados similares.

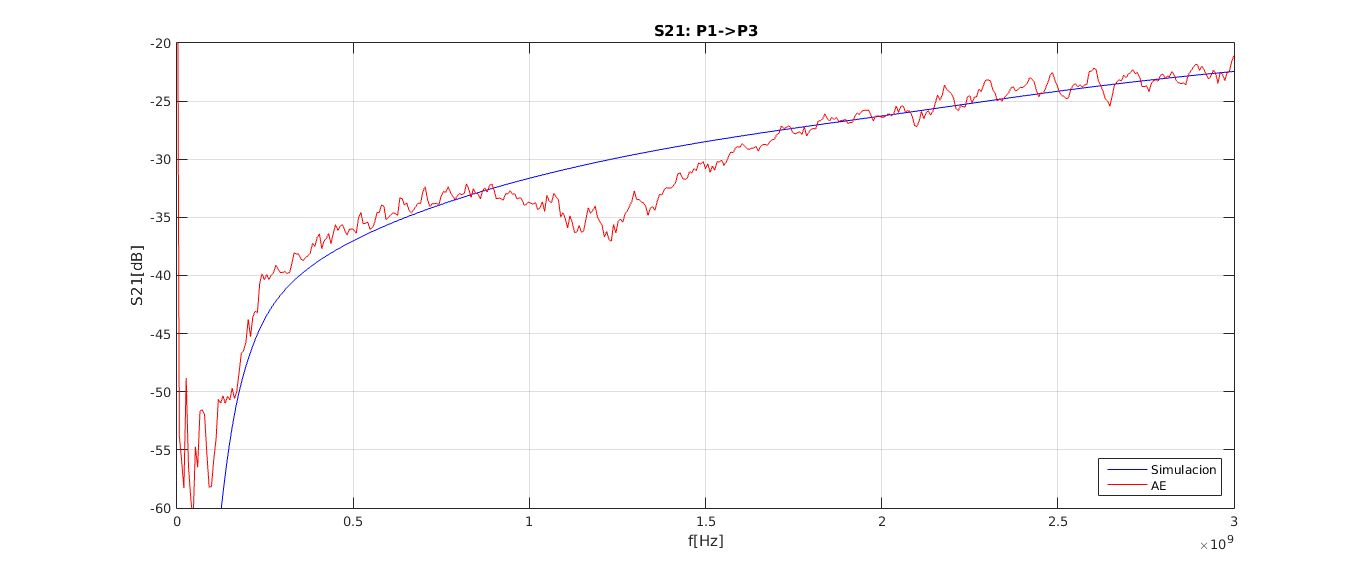
[picture p45: figure]

| Fig. 27: S21 simulado (azul) y medido con AE (rojo), en estado “A”
| En la Fig. 28 se muestra el parámetro S33 en estado “A”. Al igual que con S21, no hay diferencias notables entre el estado “A” y “B” para este parámetro. En este caso las mediciones arrojan resultados muy

distintos a la simulación. Esto se debe posiblemente a desadaptaciones que produce la placa que no fueron contempladas al simular.

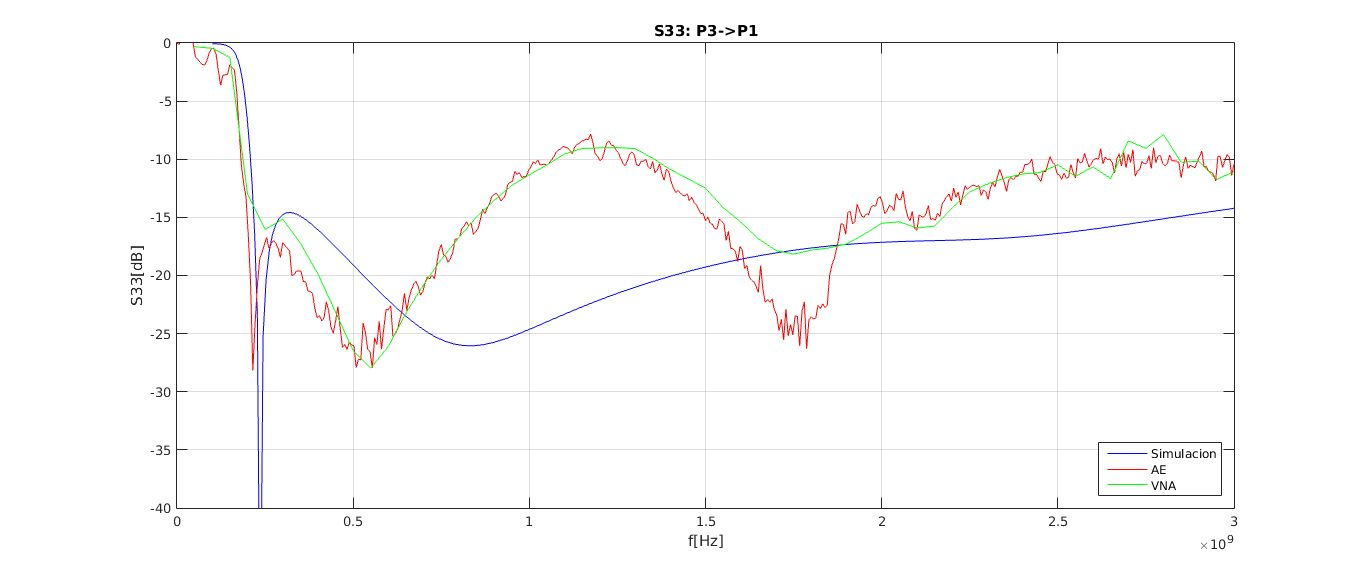
[picture p46: figure]

| Fig. 28: S33 simulado (azul), medido con VNA (verde) y medido con AE (rojo), en estado “A”
| Como resumen, el switch diseñado tiene un rango de trabajo de 200 MHz a 3 GHz. Presenta un coeficiente de reflexión máximo aproximado de -10 dB en 1,2 GHz para todos los puertos. Debido a la desadaptación, la transmisión encuentra su mayor atenuación también en 1,2 GHz alcanzando un valor de -5 dB. En cuanto a crosstalk y aislación, los peores valores alcanzados fueron de aproximadamente -22 dB en 3 GHz.

### 4. DISCUSIÓN

Las principales diferencias entre lo simulado y medido se deben a las desadaptaciones producidas por la placa. Estas no aparecen en las simulaciones porque sólo se contemplaron los componentes discretos utilizados.
La frecuencia de corte inferior actual está limitada por el filtro T y a los inductores del Bias-Tee. Esta misma puede disminuirse utilizando otras topologías o con la adición de más componentes de otras tecnologías que permitan alcanzar valores más convenientes limitando los efectos de la autoresonancia. En cuanto a la aislación entre puertos, esta se ve perjudicada por los efectos capacitivos parásitos de los diodos pin. Estos efectos pueden ser reducidos colocando más de un diodo pin en serie con lo cual aumentaría la aislación pero empeoraría el insertion loss.
La frecuencia de corte superior no fue alcanzada durante las mediciones ya que no poseemos instrumental que lo permita. Teóricamente, la frecuencia de corte superior va a estar dada por la autoresonancia de las bobinas que se utilizaron, aunque los diodos pin permitan trabajar hasta 6 GHz.

### 5. CONCLUSIONES

Durante el desarrollo de este trabajo, se diseñó, implementó y caracterizó un switch SPDT de RF disipativo. La principal especificación propuesta al comienzo fue que funcione hasta 3 GHz.
Partiendo de esto y utilizando una topología a diodos pin, se realizó un switch que funciona entre 200 MHz y 3 GHz con una insertion loss máxima de 5 dB, un coeficiente de reflexión máximo de -10 dB y aislación entre los puertos de 22 dB.
Si los resultados obtenidos son comparados con la simulación, se perciben grandes diferencias debido a que la modelización fue de parámetros concentrados, no incluyendo los efectos del diseño de la placa. Se encontró en 1,2 GHz la mayor disparidad respecto a las simulaciones.

La realización de este proyecto nos hizo ver grandes problemas que aparecen a la hora de realizar un circuito en RF. El diseño de la placa y la elección de la tecnología de los componentes a utilizar no son tareas sencillas. La existencia de herramientas de simulación y cálculo para RF facilita mucho el diseño de los sistemas.
A pesar de las diferencias con las simulaciones, se puede decir que el switch cumplió con lo esperado desde el punto de vista del diseño, ya que funcionó correctamente en el ancho de banda buscado. Algunas mejoras posibles para el mismo pueden ser bajar la frecuencia de corte inferior y mejorar la aislación entre puertos.

AGRADECIMIENTOS

Agradecemos a Alejandro Almela y Carlos Varela de ITEDA por haber realizado la fabricación del PCB en su laboratorio, otorgándole una calidad muy superior a la que se podría haber conseguido por métodos caseros.
También al cuerpo docente de la materia presente en el RFlab de la UTN-FRBA, por su constante seguimiento del trabajo y por su buena predisposición para orientarnos al realizar las mediciones, además de haber provisto un componente que no se conseguía en el mercado local.

### 6. REFERENCIAS

[1] P. Bacon, D. Fischer, R. Lourens, “Overview of RF Switch Technology and Applications, http://www.mwjournal-digital.com/mwjournal/201407?sub_id=j0GeXPfOndep&u1=5356C4948023B0Y&folio=76&pg=76#pg76, (http://www.mwjournal-digital.com/mwjournal/201407?sub_id=j0GeXPfOndep&u1=5356C4948023B0Y&folio=76&pg=76) consultado el 11/12/2016.
[2] AgilentⓇ, AN922 “Applications of PIN Diodes”, Noviembre 1999, http://literature.agilent.com/litweb/pdf/5965-8666E.pdf, consultado el 16/12/2016.
[3] InfineonⓇ, BAR 64-02V datasheet, http://www.infineon.com/dgdl/Infineon-BAR64series-DS-v01_02-EN.pdf?fileId=5546d4625607bd130156121f 289c38b5, (http://www.infineon.com/dgdl/Infineon-BAR64series-DS-v01_02-EN.pdf?fileId=5546d4625607bd130156121f289c38b5) consultado el 11/12/2016
[4] G. W. Johnson, “Wideband Bias Tee”, http://wb9jps.com/Gary_Johnson/Bias_Tee_files/Bias_Tee_Design_V2R.pdf, consultado el 11/12/2016.
[5] MurataⓇ, part number LQW18ANR47J00D, “Chip Inductor datasheet”, http://www.mouser.com/ds/2/281/o05e-522697.pdf, pág. 203, consultado el 11/12/2016.
[6] Roger corporationⓇ, RO4350B™ laminate, “RO4000seriesⓇ datasheet”, https://www.rogerscorp.com/documents/726/acs/RO4000-LaminatesData-sheet.pdf, consultado el 11/12/2016.
[7] RS ProⓇ, part number R19-070-01-0032210LL datasheet, http://docs-europe.electrocomponents.com/webdocs/1510/0900766b81510765.pdf, consultado el 11/12/2016.
[8] Tyco ElectronicsⓇ, part number 36501J22NJTDG, “Chip inductor series 3650 datasheet” http://docs-europe.electrocomponents.com/webdocs/0660/0900766b80660964.pdf, pág. 2, consultado el 11/12/2016.
[9] KemetⓇ, part number C0603C100J5GACTU, “Surface Mount Ceramic Chip Capacitors”, http://docs-europe.electrocomponents.com/webdocs/1515/0900766b8151507f.pdf
[10] A. Henze, G. Monasterios, 1 GHz Automatic 2-Port Vector Network Analyzer Using Common Laboratory Instruments,
https://www.researchgate.net/publication/263306917_1_GHz_Automatic_2-Port_Vector_Network_Analyzer_Using_Common_Laboratory_Instruments (https://www.researchgate.net/publication/263306917_1_GHz_Automatic_2-Port_Vector_Network_Analyzer_Using_Common_Laboratory_Instruments)

### 7. ANEXOS

Tablas con resultados de las mediciones

Los módulos de los parámetros se encuentran expresados en dB, sus respectivas fases en grados y la frecuencia en MHz.
Señal incidente en puerto 1 - Estado “A”
VNA | AE | Sim
Freq | |S11| | Fase S11 | |S21| | Fase S21 | |S31| | Fase S31 | |S11| | |S21| | |S31| | |S11| | |S21| | |S31|
50 | -0.02 | -8.11 | | | -Inf | 0.00 | -1.35 | -56.05 | -55.59 | 0.00 | -101.31 | -101.30
100 | -0.49 | -40.72 | | | -Inf | 0.00 | -1.40 | -55.27 | -55.36 | -0.21 | -68.21 | -68.16
150 | -0.80 | -70.84 | | | -Inf | 0.00 | -4.03 | -48.55 | -53.94 | -1.83 | -54.36 | -54.25
200 | -1.25 | -119.33 | | | -Inf | 0.00 | -9.22 | -43.39 | -49.53 | -5.60 | -47.35 | -46.77
250 | -6.98 | 154.69 | | | -46.99 | -69.16 | -15.26 | -41.79 | -47.42 | -9.89 | -43.67 | -43.20
300 | -16.25 | -120.39 | | | -40.71 | -141.14 | -18.96 | -38.80 | -38.68 | -13.81 | -41.45 | -41.10
350 | -14.78 | -162.19 | | | -39.57 | 171.87 | -19.59 | -38.70 | -38.46 | -17.27 | -39.93 | -39.63
450 | -18.02 | 171.66 | | | -38.15 | 144.48 | -23.31 | -36.36 | -36.16 | -23.28 | -37.83 | -37.56
500 | -23.07 | 160.21 | | | -36.53 | 118.95 | -25.80 | -35.68 | -36.40 | -25.99 | -37.02 | -36.77
600 | -25.88 | -173.28 | | | -35.41 | 94.09 | -24.93 | -35.29 | -36.05 | -31.10 | -35.61 | -35.37
700 | -21.22 | -147.84 | | | -34.28 | 73.01 | -27.30 | -32.80 | -35.16 | -33.43 | -34.43 | -34.18
800 | -16.74 | -161.01 | | | -33.51 | 49.33 | -21.69 | -32.95 | -35.72 | -31.80 | -33.41 | -33.16
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
2650 | -12.11 | 118.15 | -1.52 | 0.01 | | | -9.99 | -5.73 | -27.54 | -16.00 | -0.83 | -23.35
3000 | -12.46 | 68.57 | -0.24 | -1.10 | | | -10.40 | -2.61 | -23.79 | -14.39 | -0.79 | -22.21

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
| Tabla 8: Señal incidente en puerto 3 - Estado “B”.
