akukulanski/RF_Switch_3GHz/Presentación/RF_Switch_Presentacion.pdf

## RF SWITCH

- Carducci, Nahuel
- Cinetto, Cristian
- Demski, Andrés
- Kukulanski, Ariel
- Paunovic, Iván

## Índice

- Descripción del proyecto.
- Diodos PIN.
- Esquema ideal.
- Bias Tee.
- Esquema final.
- Desarrollo del PCB.
- Sets de medición.
- Mediciones y Simulaciones.
- Conclusiones

## Switch SPDT

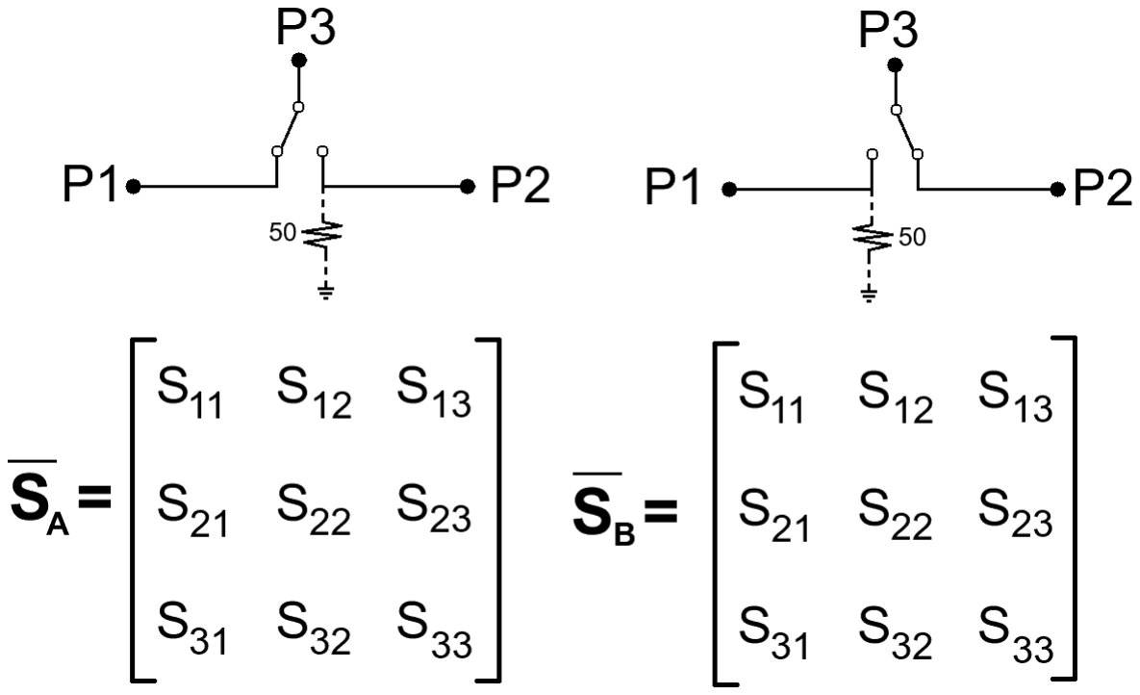
[picture p47: figure]

## Switch SPDT - Especificaciones

- Funcional hasta 3 GHz
- Ancho de banda de al menos 1 década
- Carga fantasma de 50 ohm en puerto desconectado

## Esquema ideal

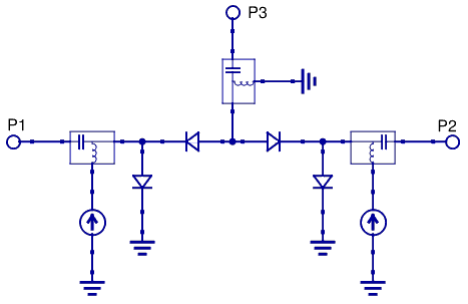
[picture p48: figure]

## Características del Diodo PIN

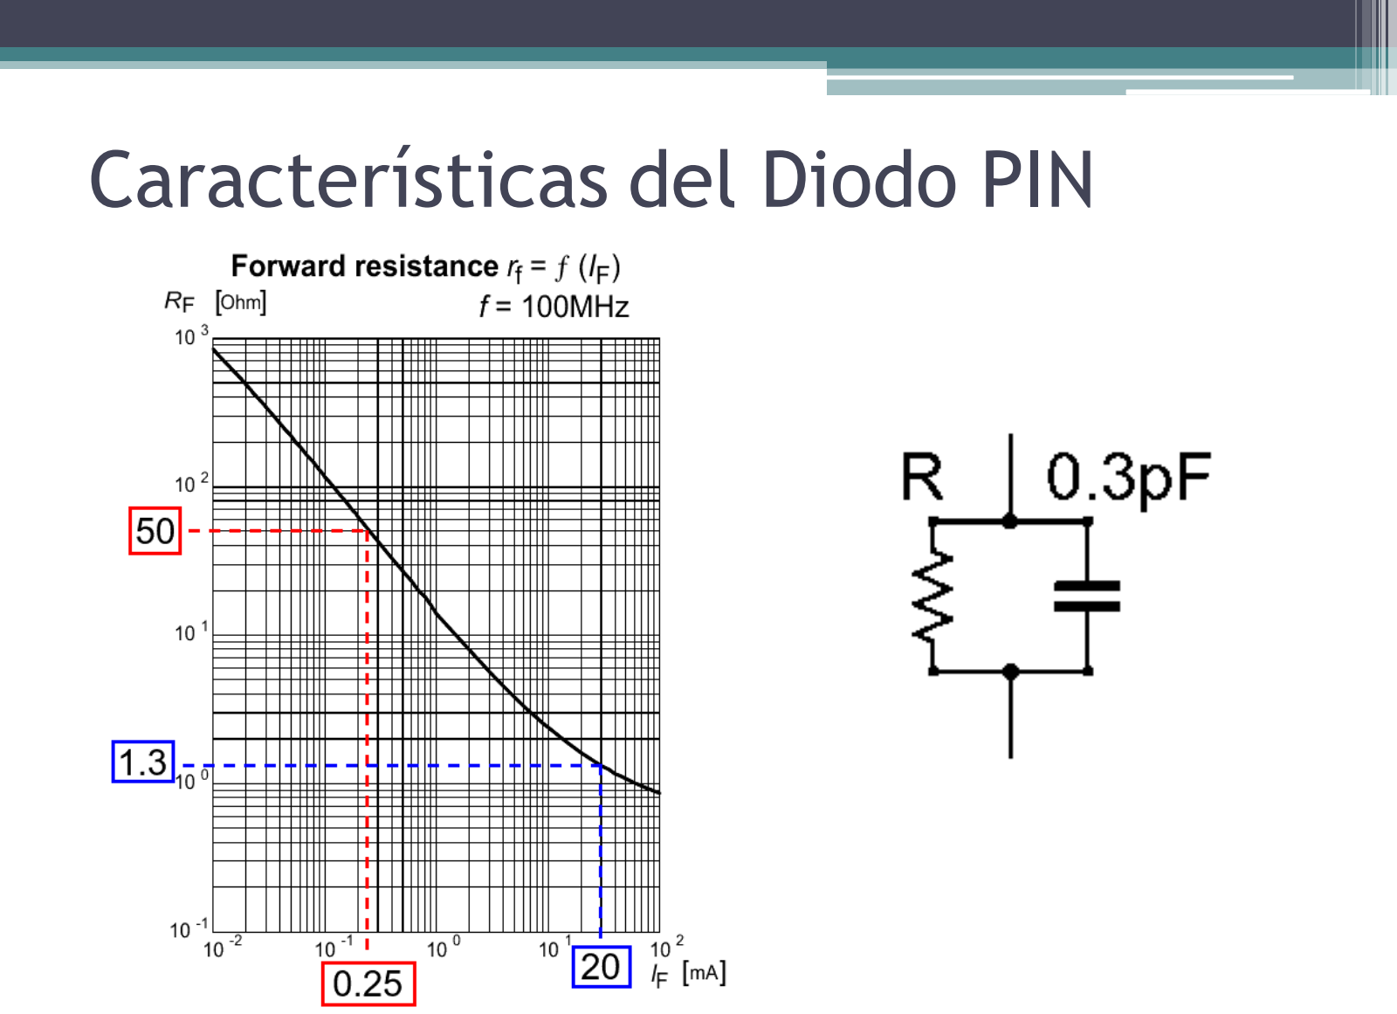
[picture p49: page 6]

## Capacitor de Desacople de CC

- Implementación: Filtro T

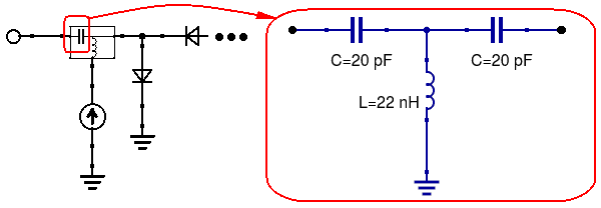
[picture p50: figure]

## Desacople de AC - Choque

- Implementación

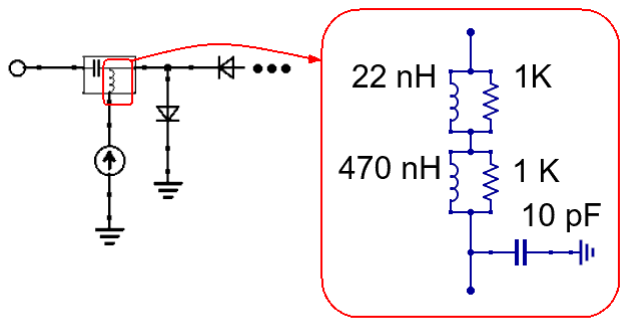
[picture p51: figure]

## Circuito Final - Schematic

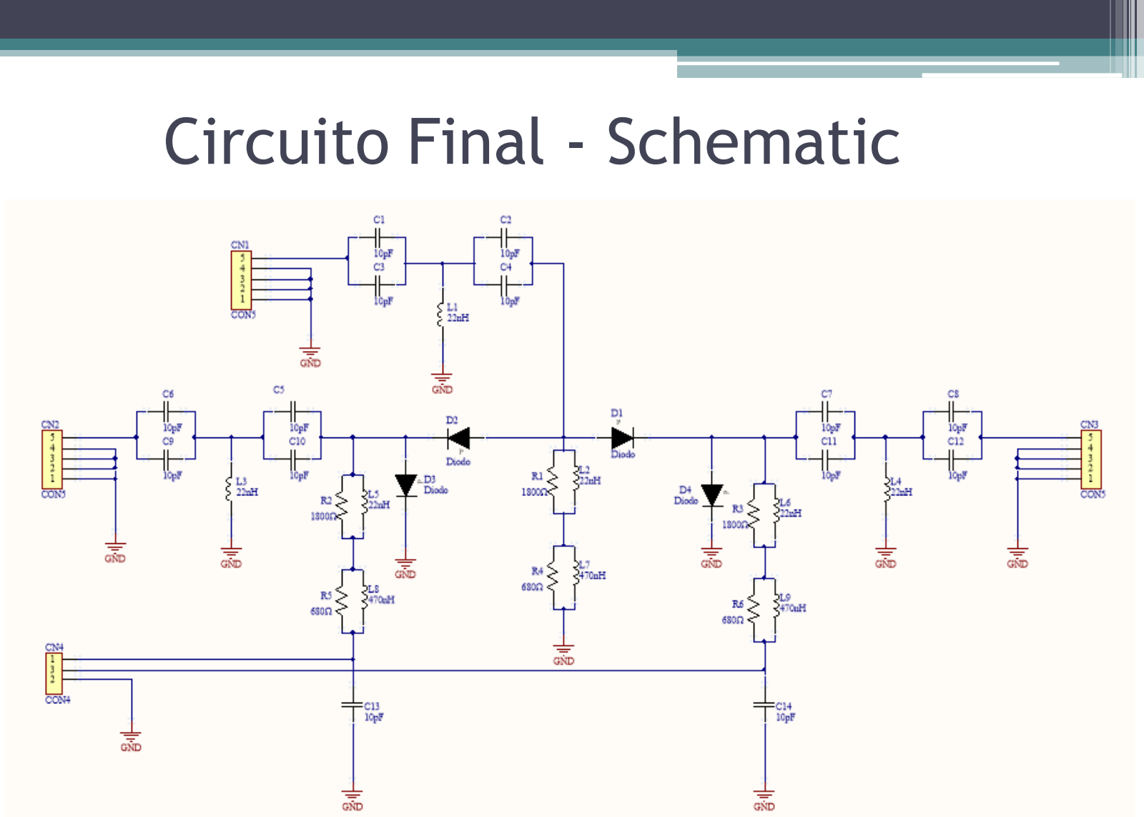
[picture p52: page 9]

## Consideraciones

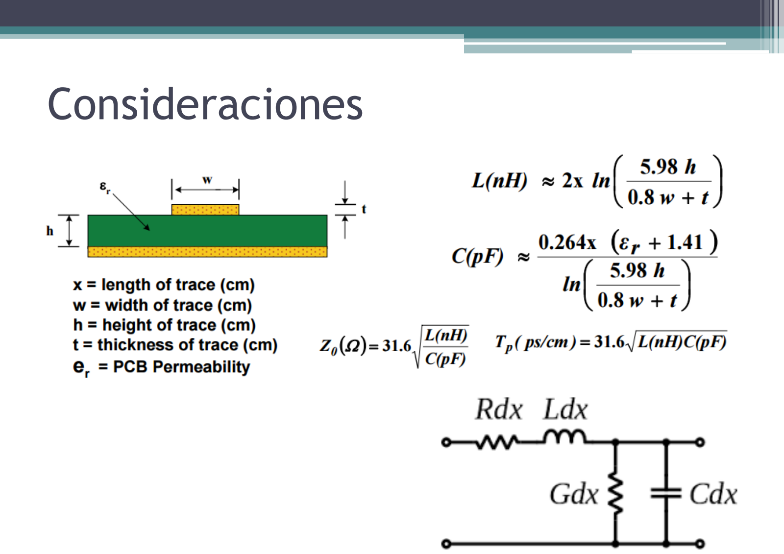
[picture p53: page 10]

## Circuito Final

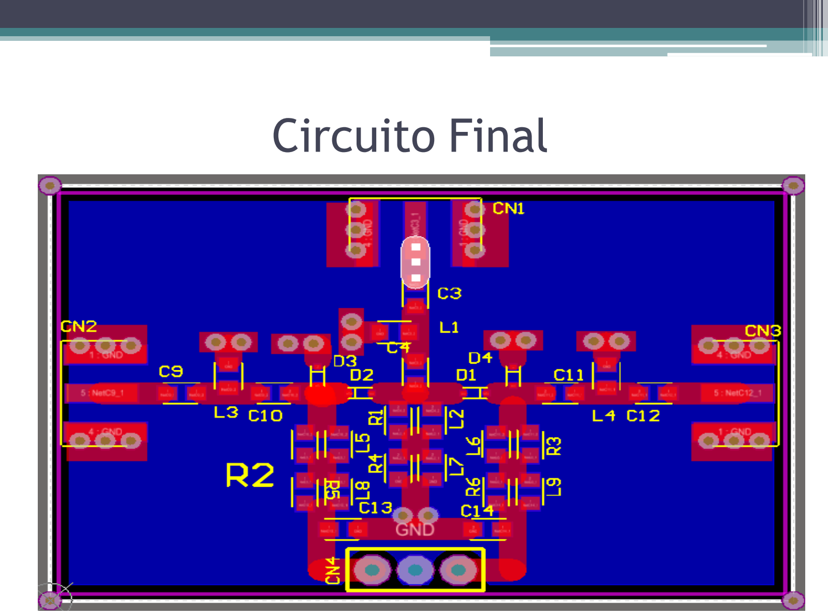
[picture p54: page 11]

## Placa realizada

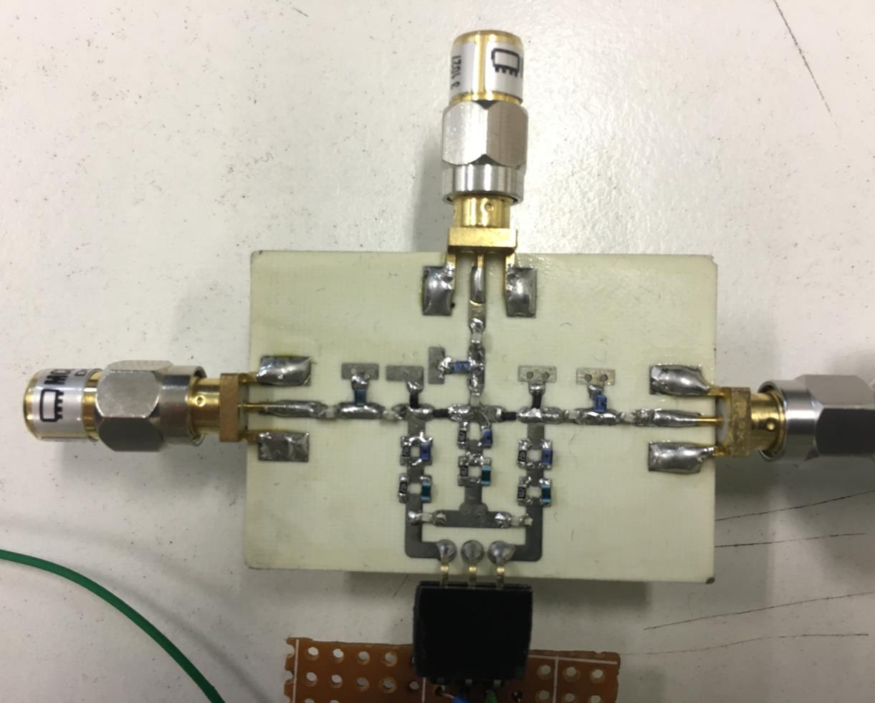
[picture p55: figure]

## Placa de Polarización

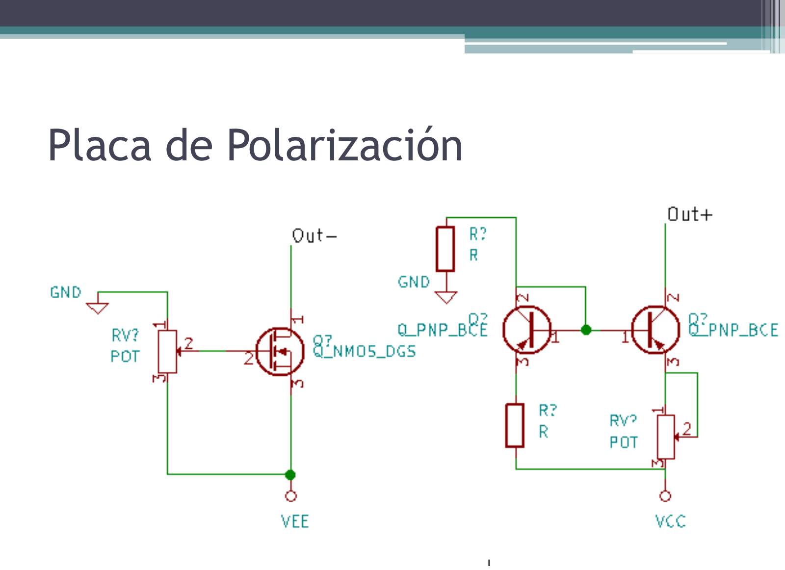
[picture p56: page 13]

### Medición con AE: Tracking Generator

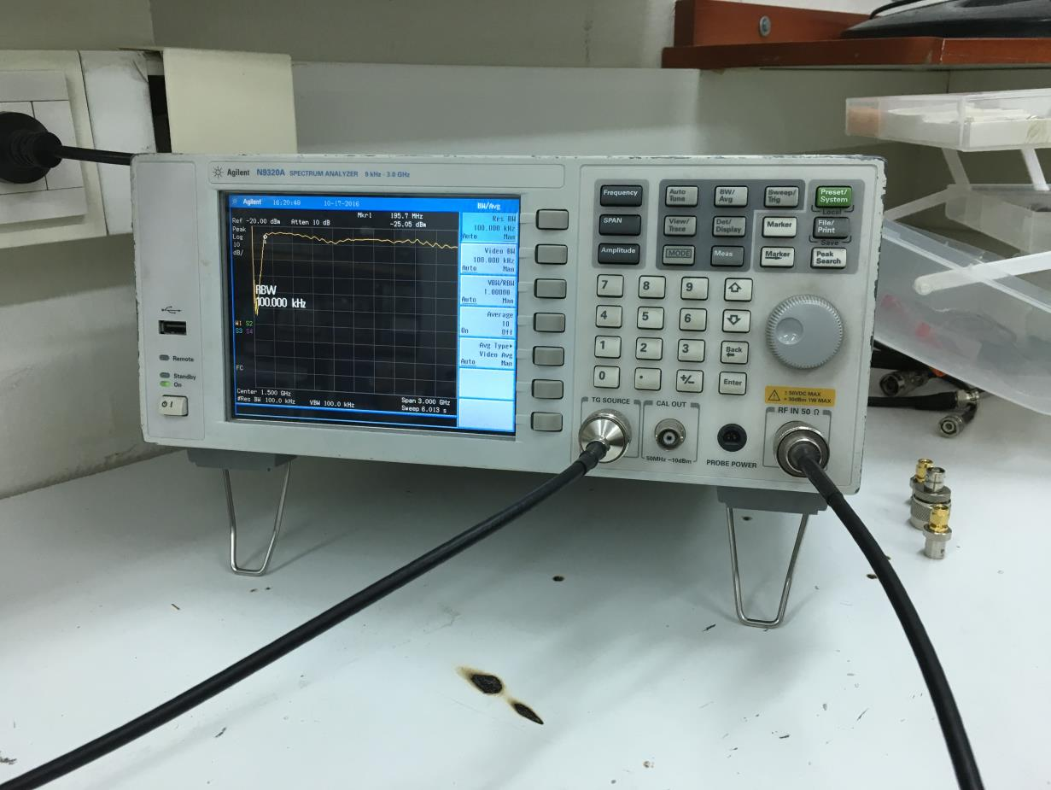
[picture p57: figure]

## Medición con AE: Setup Preliminar

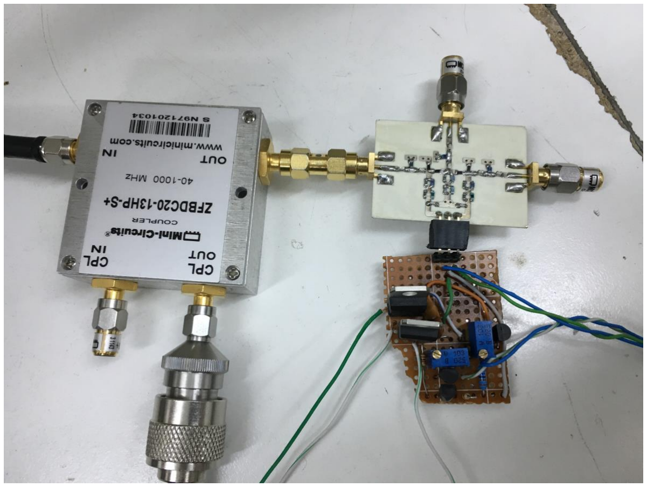
[picture p58: figure]

## Medición con AE: Setup Final

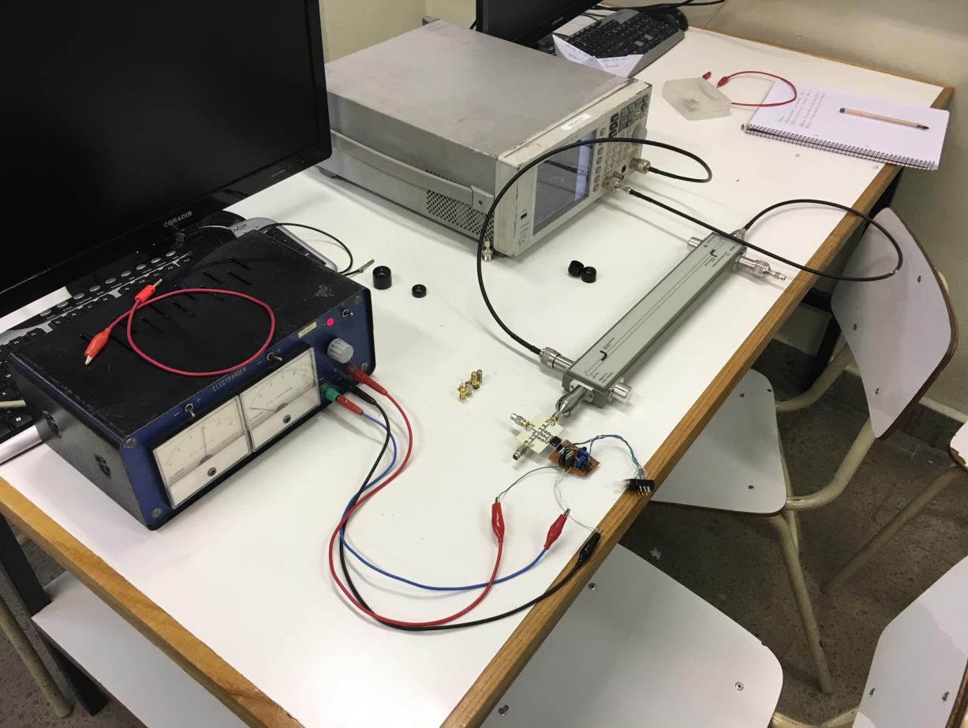
[picture p59: figure]

## Medición con VNA: Setup

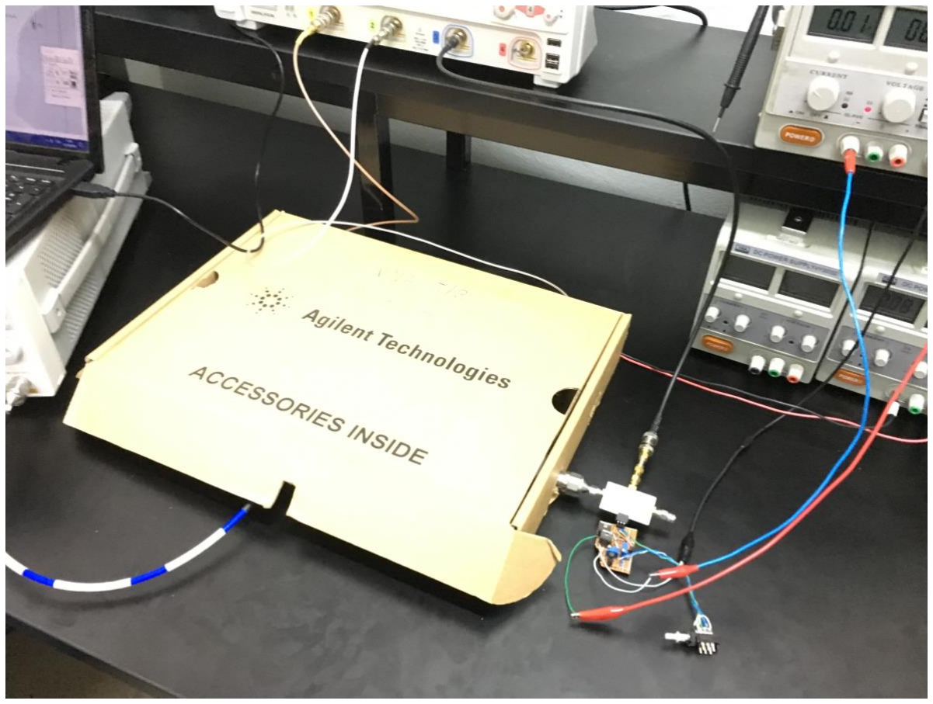
[picture p60: figure]

## Medición con AE: Normalizacion

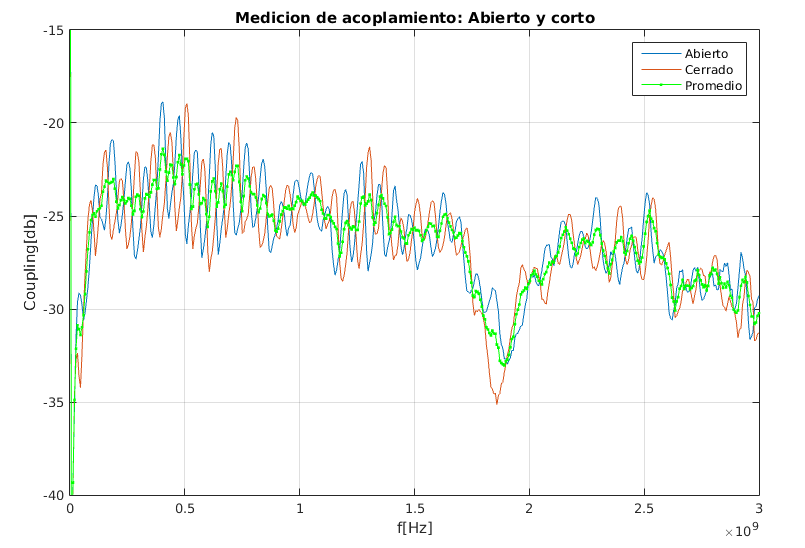
[picture p61: figure]

## Parámetros S

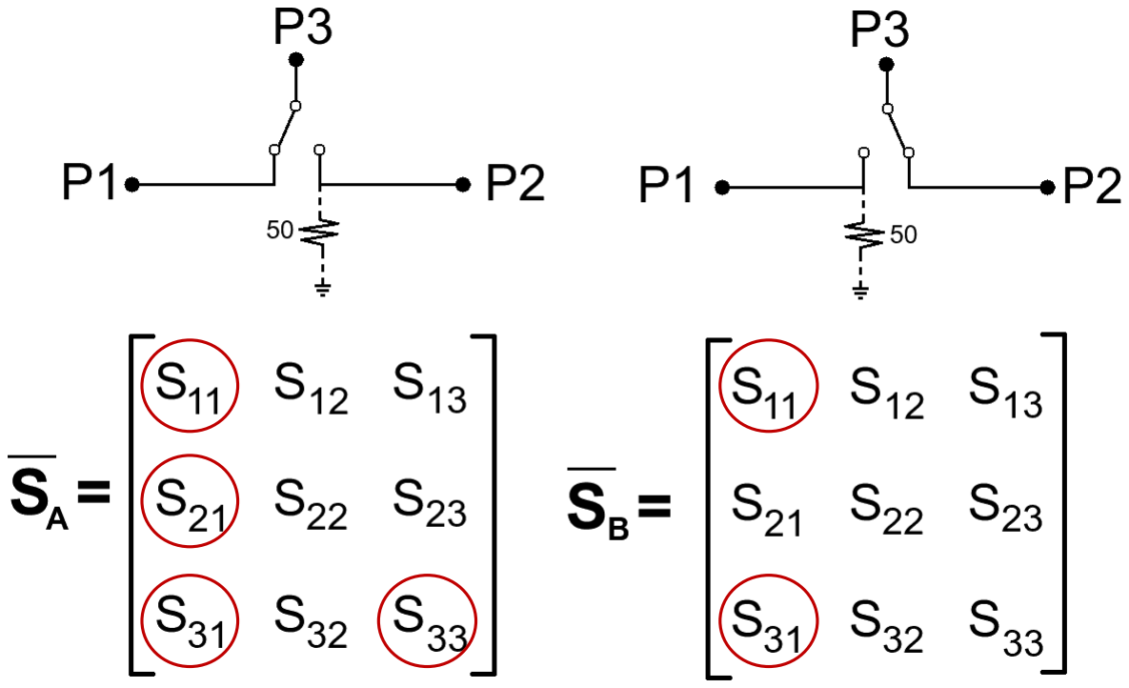
[picture p62: figure]

S11

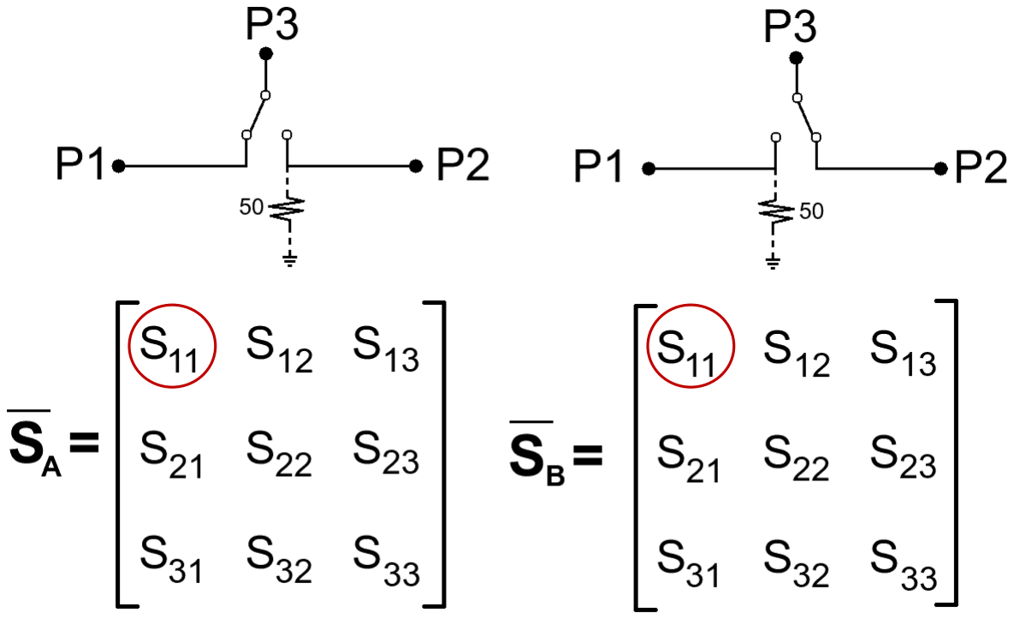
[picture p63: figure]

S11

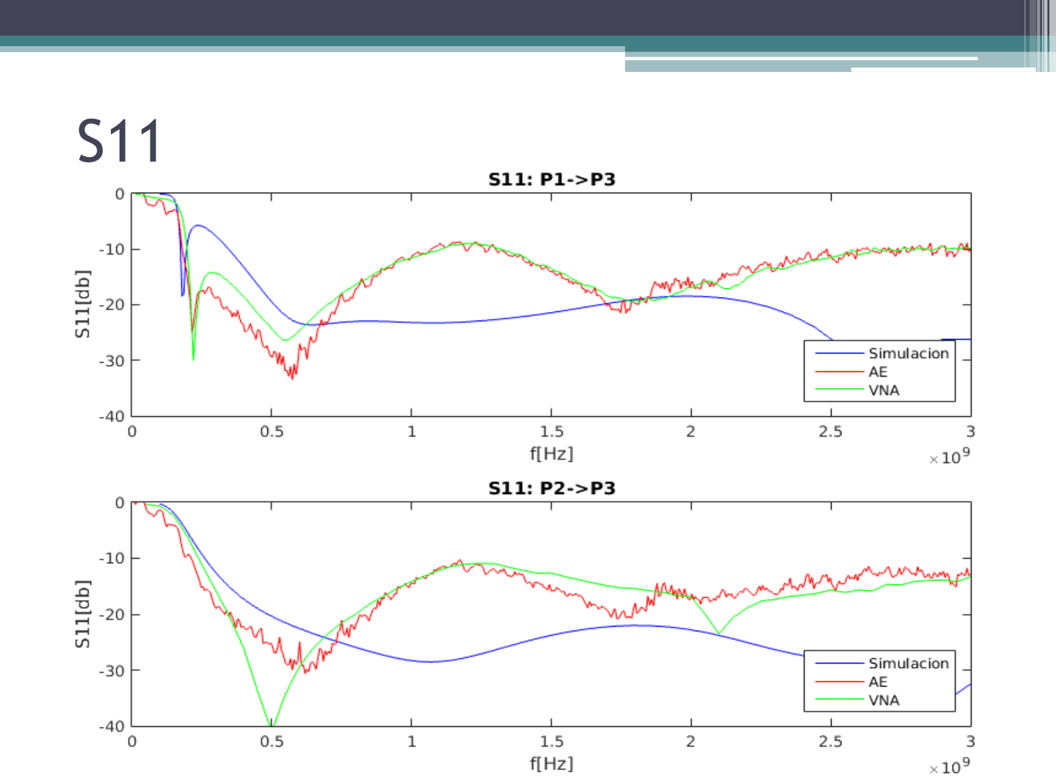
[picture p64: page 21]

S33

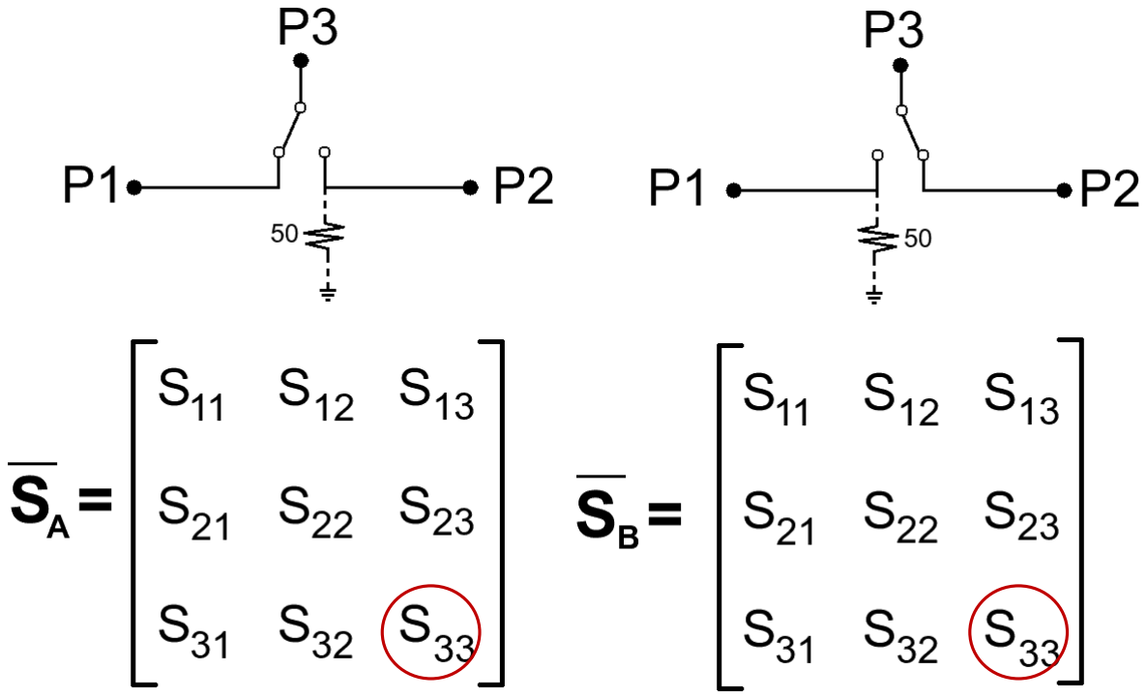
[picture p65: figure]

## S33 – ambos casos

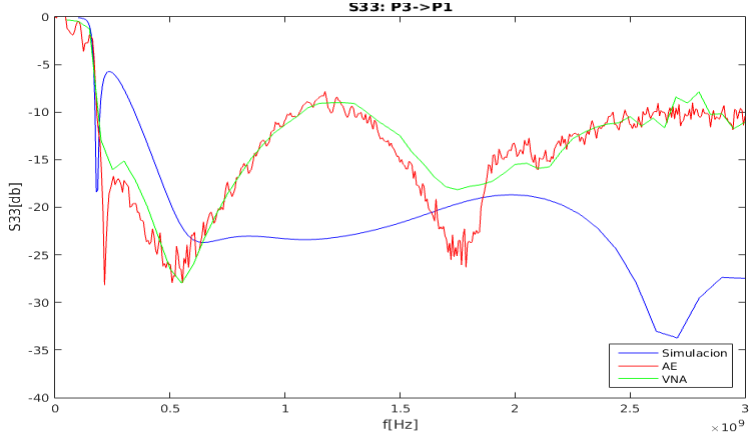
[picture p66: figure]

S31

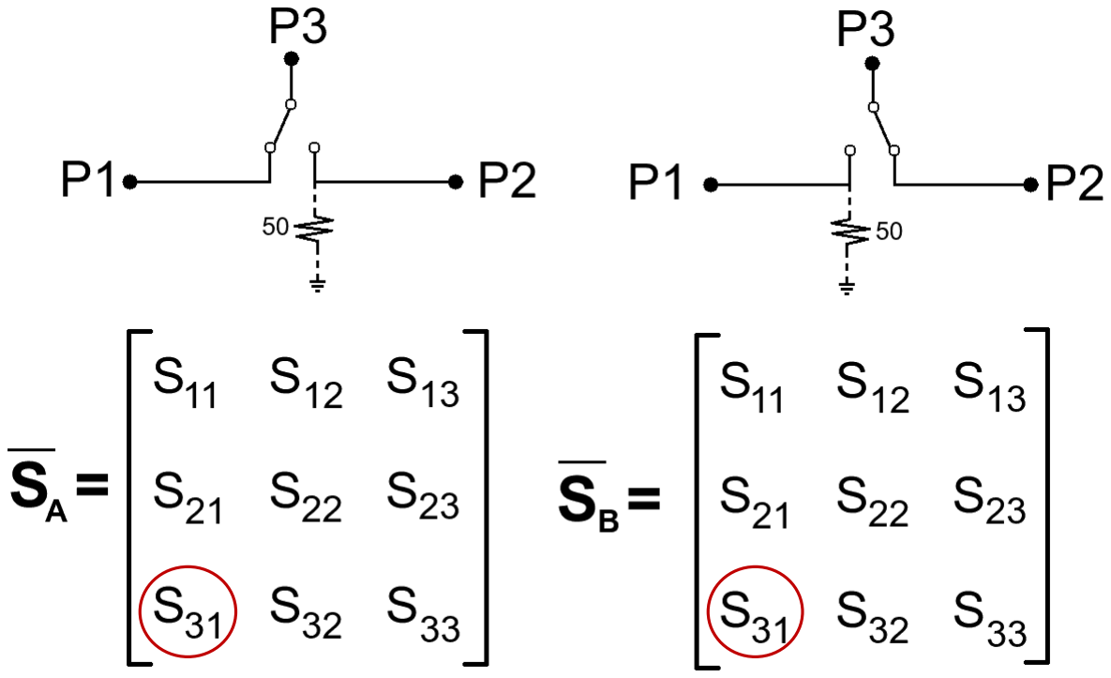
[picture p67: figure]

S31

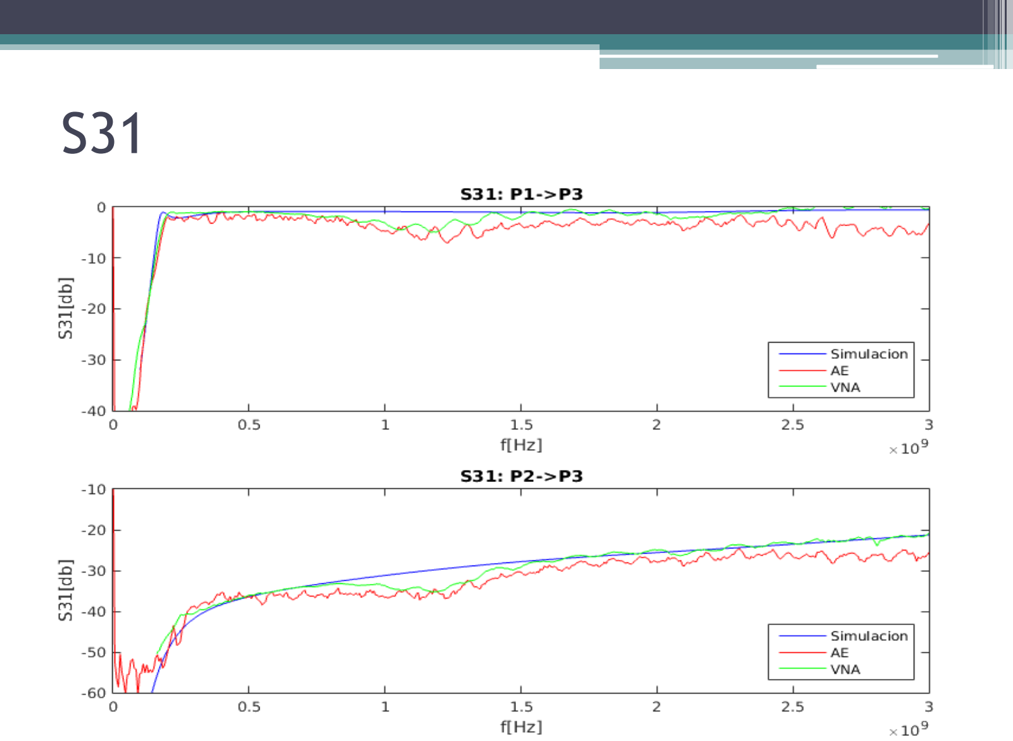
[picture p68: page 25]

## S21 – Ambos casos

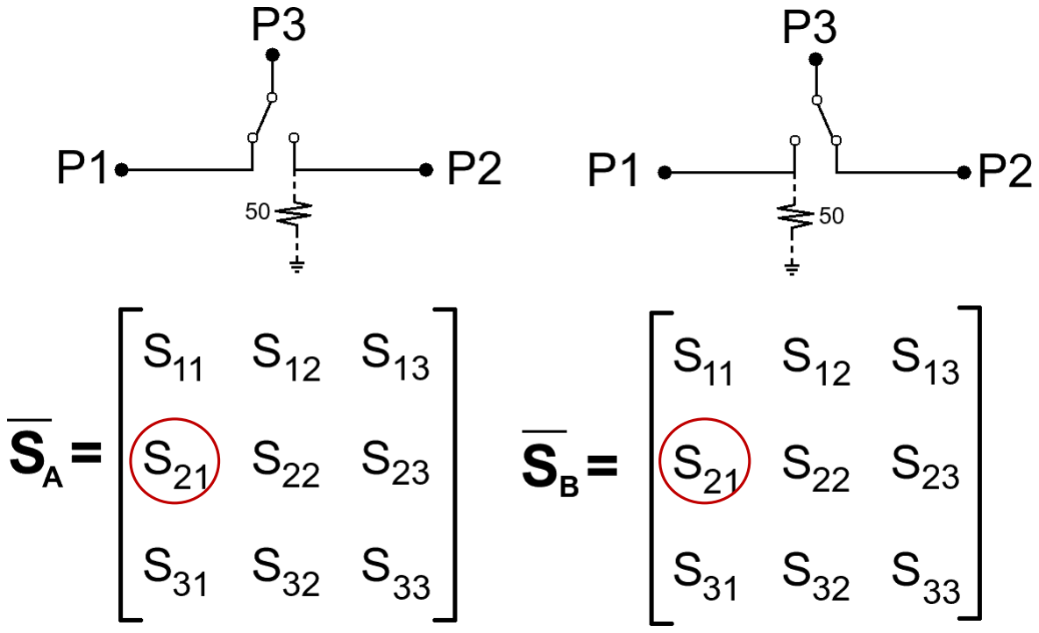
[picture p69: figure]

S21

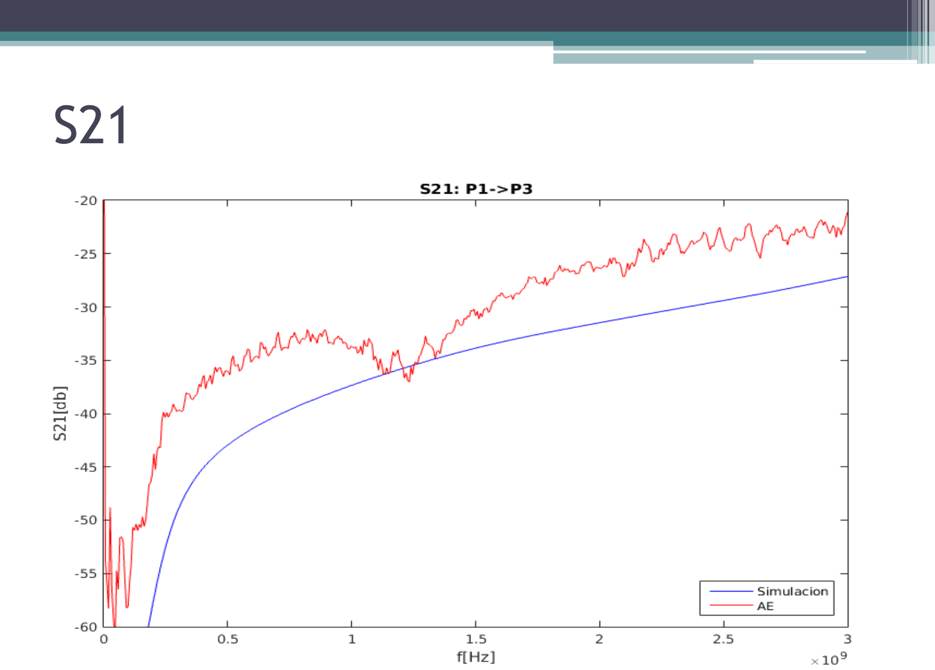
[picture p70: page 27]

## Resultados y Conclusiones

- El rango de trabajo es de 200Mhz a 3Ghz
- S11 máximo= –10dB
- S31 mínimo = -5dB (ON)
- Crosstalk máximo = -22 dB
- El circuito se comportó semejante a lo simulado
- Las alteraciones respecto a lo simulado corresponden a las capacidades parásitas de los componentes (Diodo Pin) y las desadaptaciónes producidas por la placa.

## Posibles mejoras del diseño

- Reducir la frecuencia de corte inferior.
- Lograr una mejor adaptación.
- Mejorar la placa de polarización.

## Muchas Gracias

¿Preguntas?
