akukulanski/RF_Switch_3GHz/Gráficos y datos/s11_conM.png

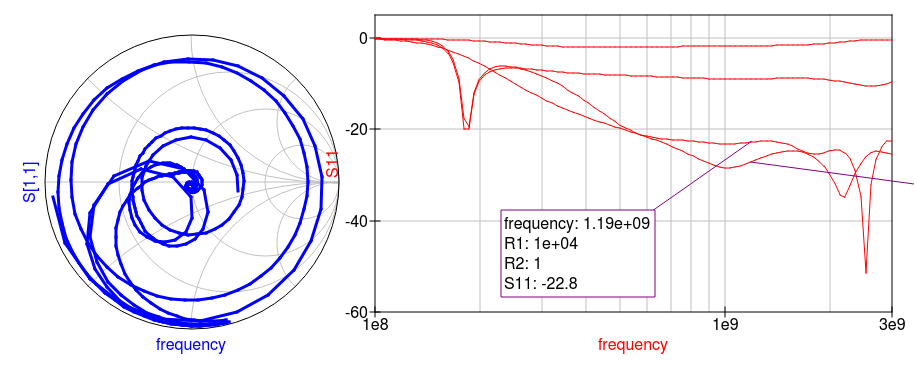
Gráficos y datos/s11_conM.png
