akukulanski/RF_Switch_3GHz/Gráficos y datos/s11_sinM.png

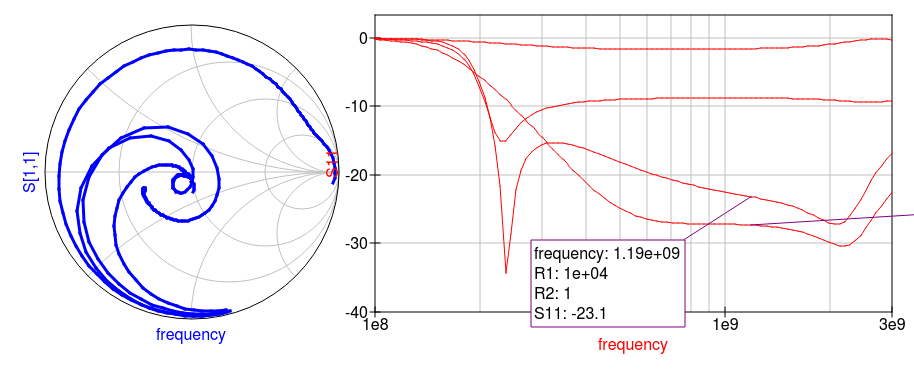
Gráficos y datos/s11_sinM.png
