akukulanski/RF_Switch_3GHz/Gráficos y datos/s21_conM.png

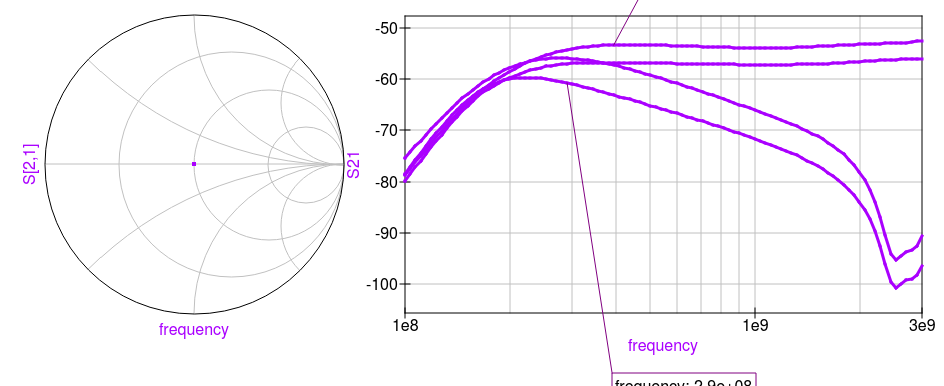
Gráficos y datos/s21_conM.png
