akukulanski/RF_Switch_3GHz/Gráficos y datos/s31_conM.png

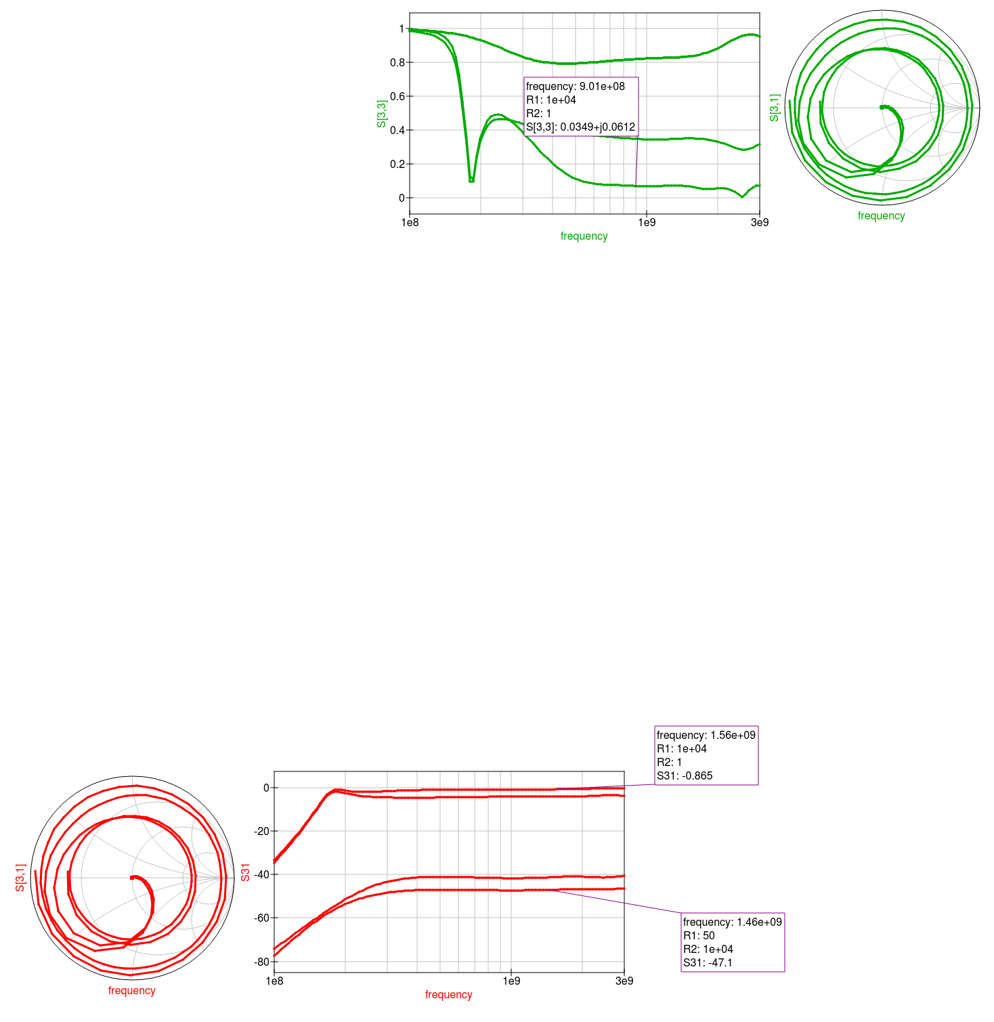
Gráficos y datos/s31_conM.png
