akukulanski/RF_Switch_3GHz/Gráficos y datos/s31_sinM.png

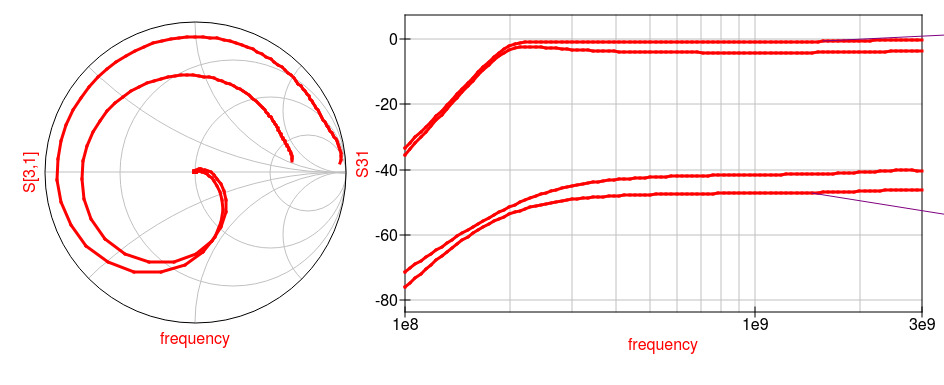
Gráficos y datos/s31_sinM.png
