akukulanski/RF_Switch_3GHz/Gráficos y datos/s33_conM.png

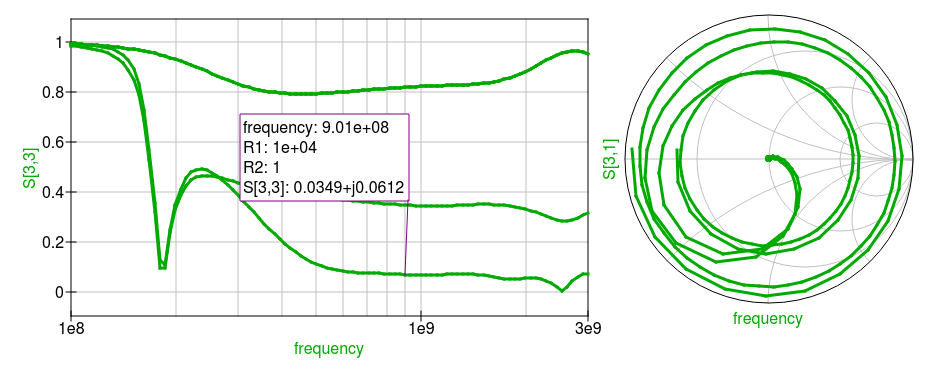
Gráficos y datos/s33_conM.png
