akukulanski/RF_Switch_3GHz/Gráficos y datos/s33_sinM.png

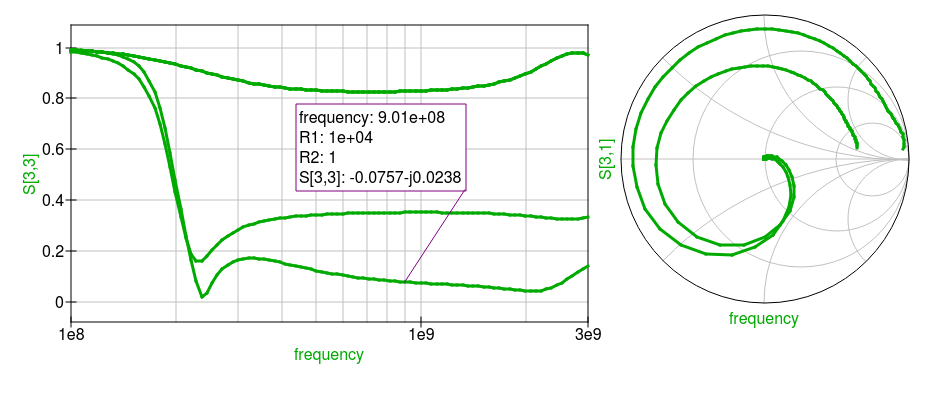
Gráficos y datos/s33_sinM.png
