akukulanski/RF_Switch_3GHz/Gráficos y datos/s41_conM.png

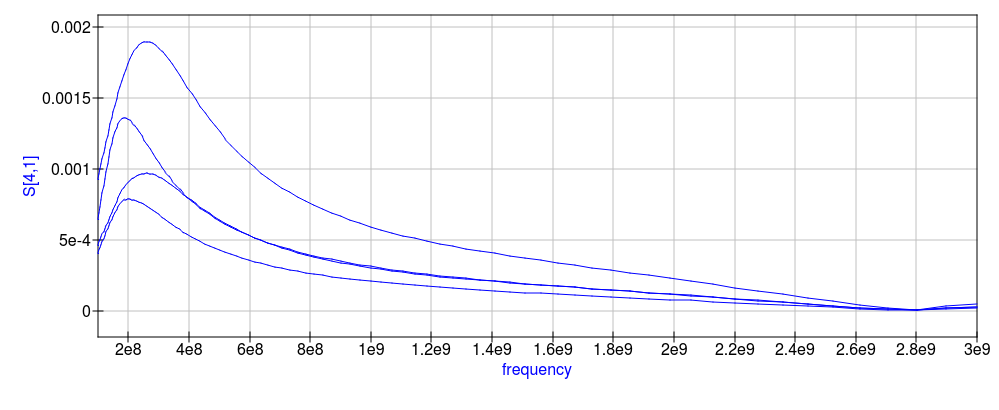
Gráficos y datos/s41_conM.png
