akukulanski/RF_Switch_3GHz/Mediciones 20161017_1700/S11_P1-OFF/SCREN096.JPG

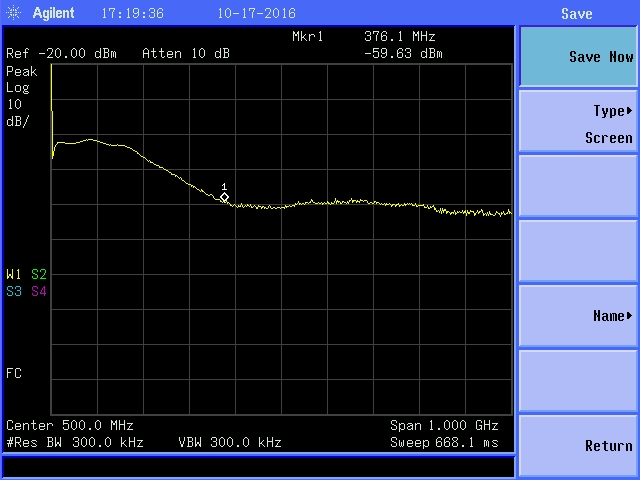
Mediciones 20161017_1700/S11_P1-OFF/SCREN096.JPG
