akukulanski/RF_Switch_3GHz/Mediciones 20161017_1700/S21_P1-OFF/SCREN107.JPG

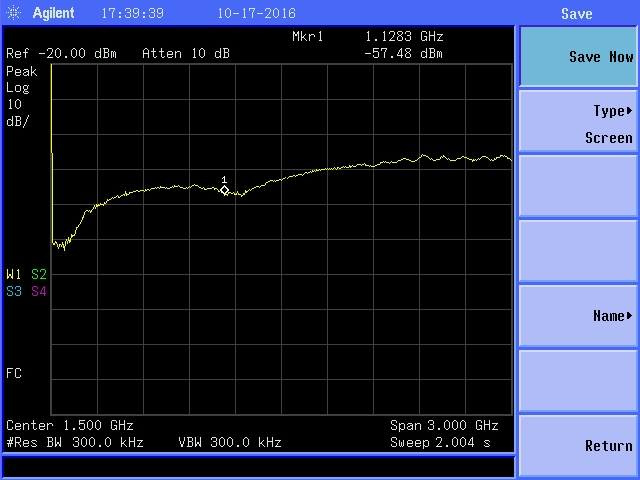
Mediciones 20161017_1700/S21_P1-OFF/SCREN107.JPG
