akukulanski/RF_Switch_3GHz/Mediciones 20161017_1700/S31_P1-ON/SCREN102.JPG

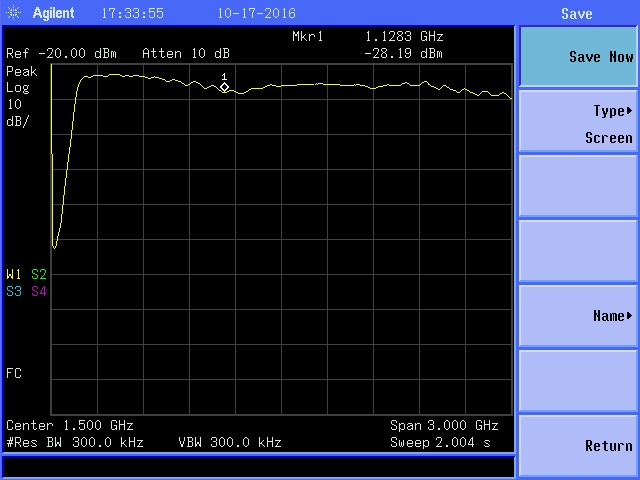
Mediciones 20161017_1700/S31_P1-ON/SCREN102.JPG
