akukulanski/RF_Switch_3GHz/placa/Proyecto3/Medidas.PDF

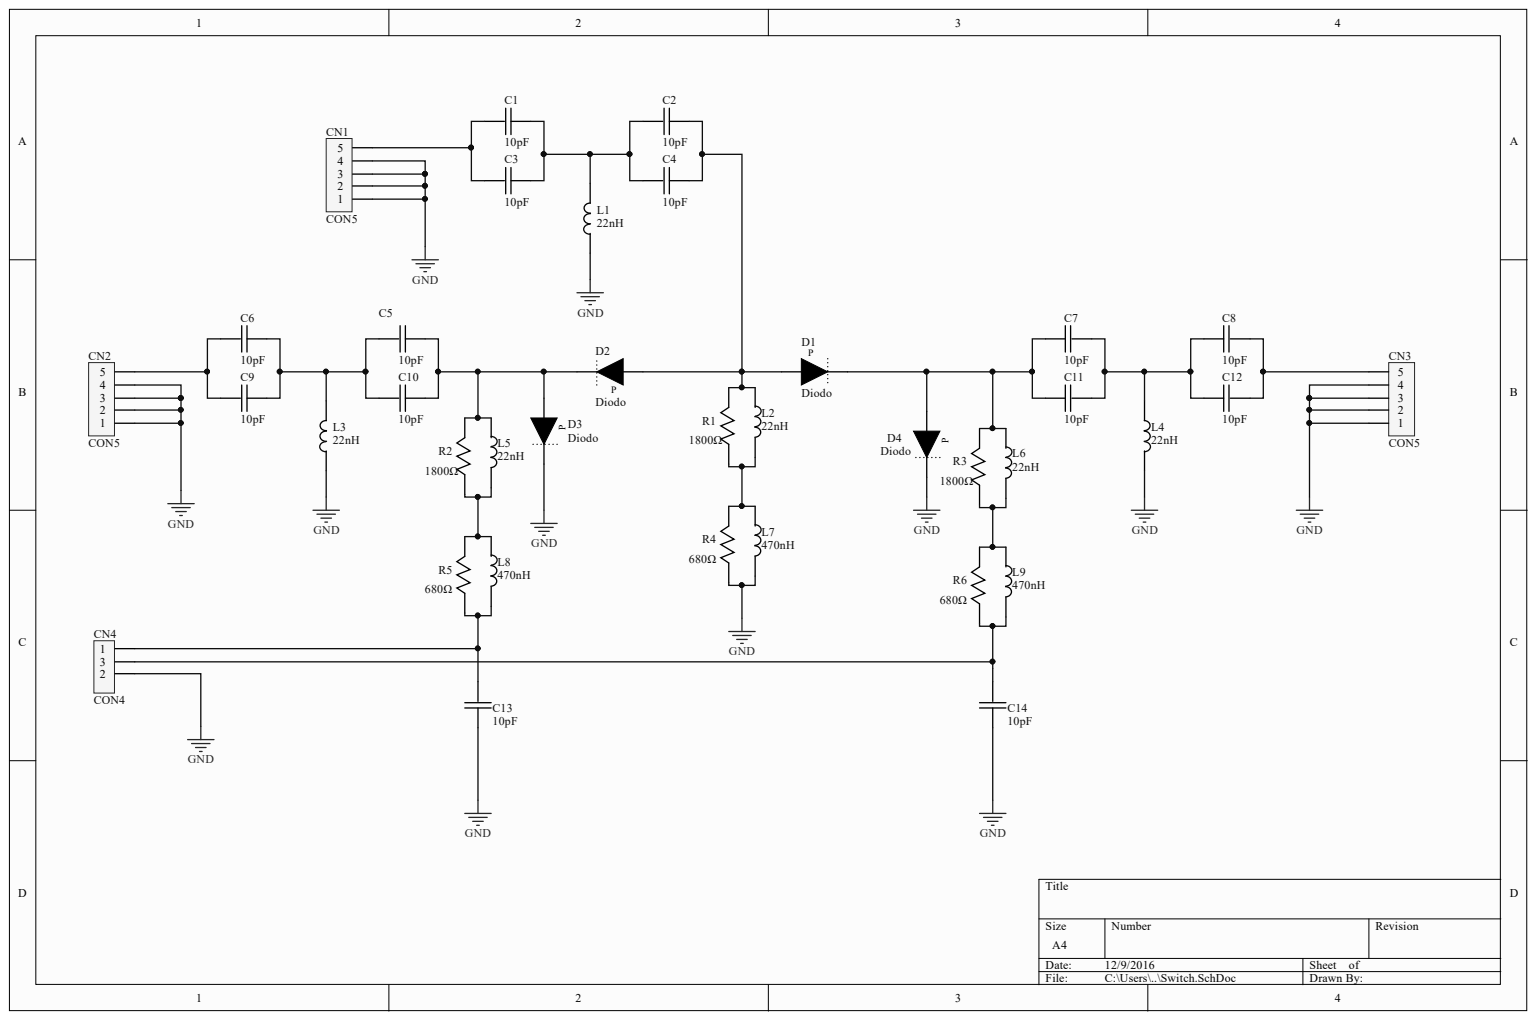
[picture p82: page 1]

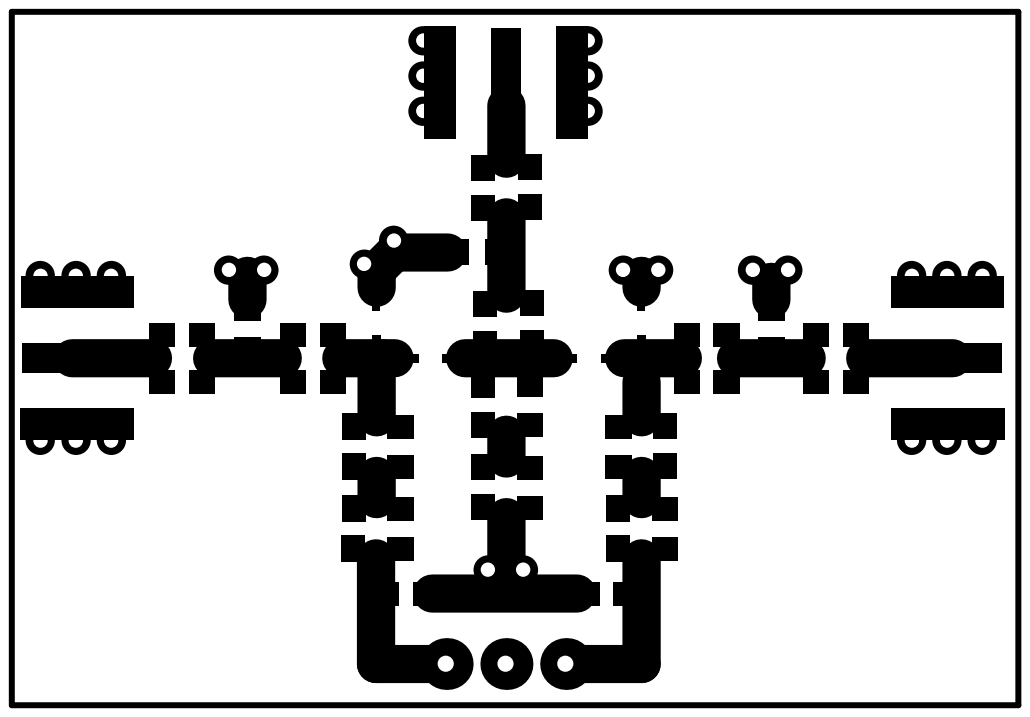
[picture p83: page 2]

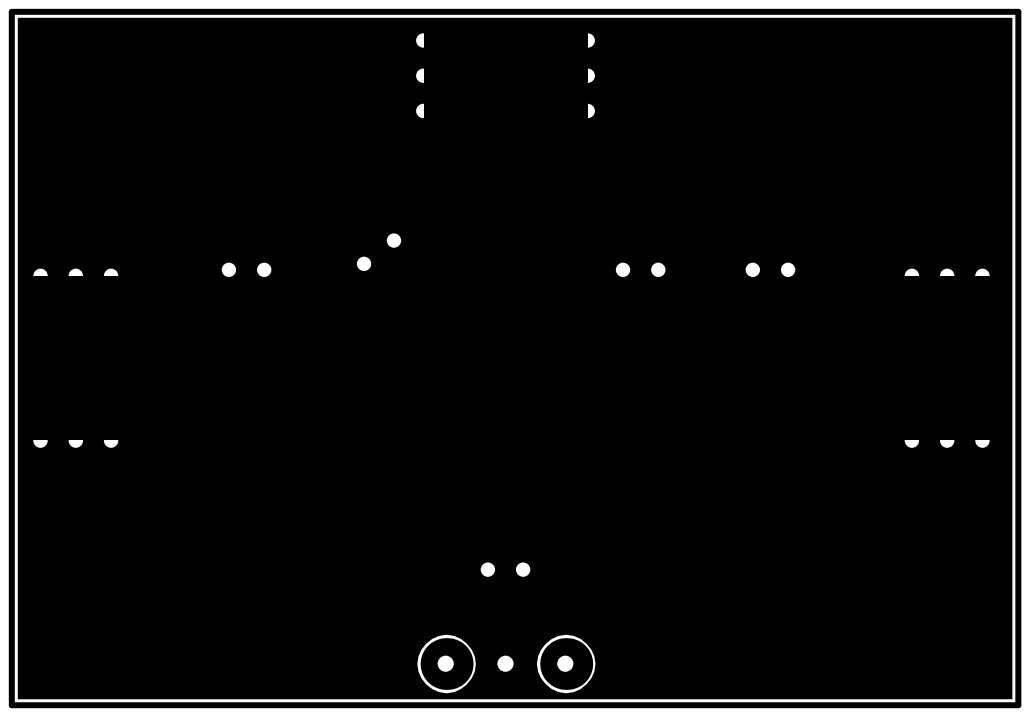
[picture p84: page 3]
