akukulanski/RF_Switch_3GHz/placa/Proyecto3/SwitchEscala.PDF

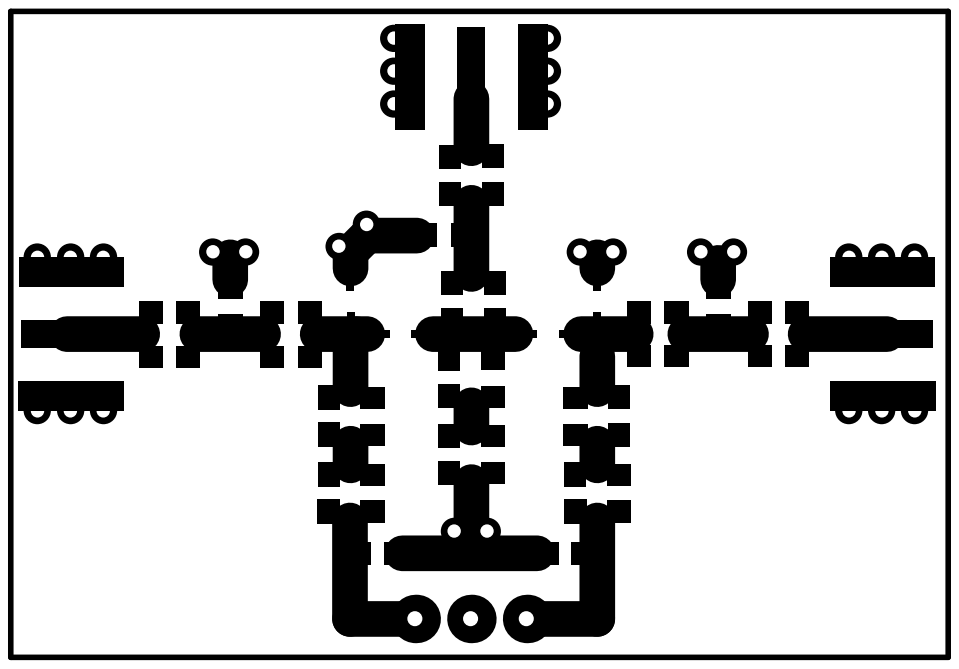
[picture p85: page 1]

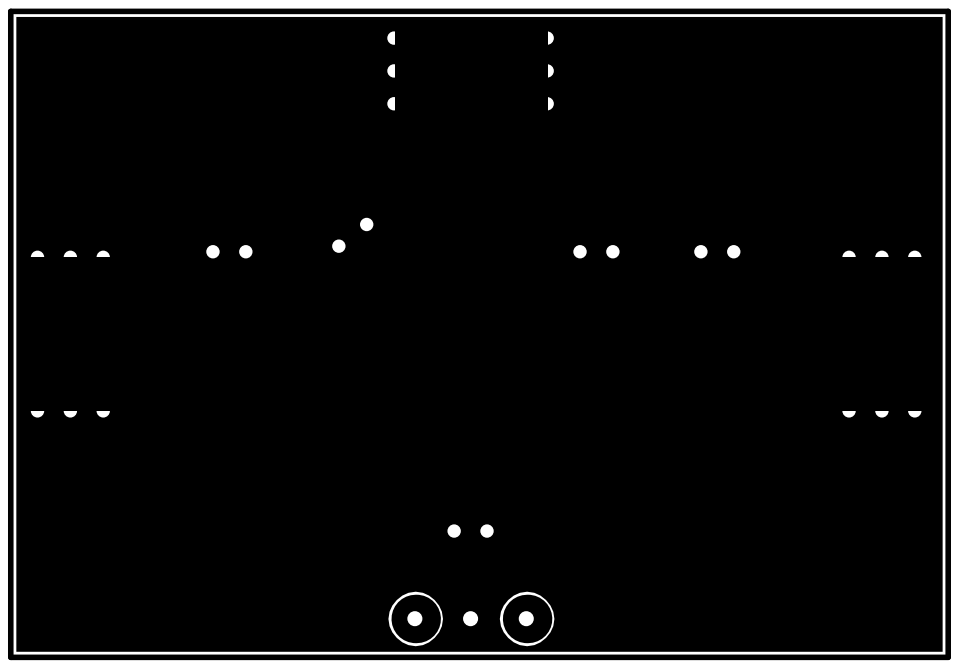
[picture p86: page 2]
