akukulanski/RF_Switch_3GHz/placa/Proyecto3/SwitchEscalaMirror.PDF

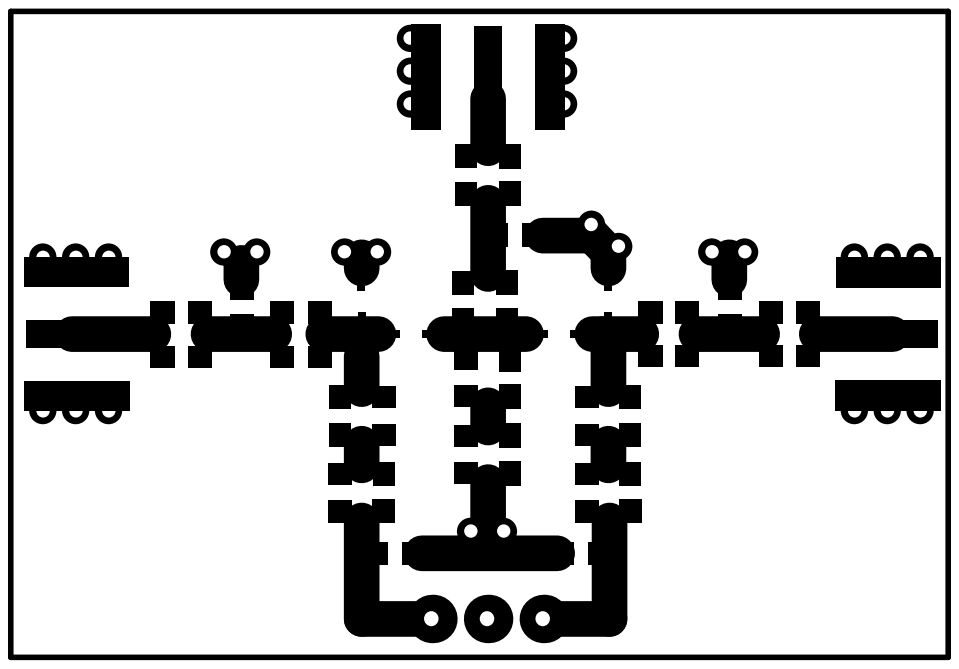
[picture p87: page 1]

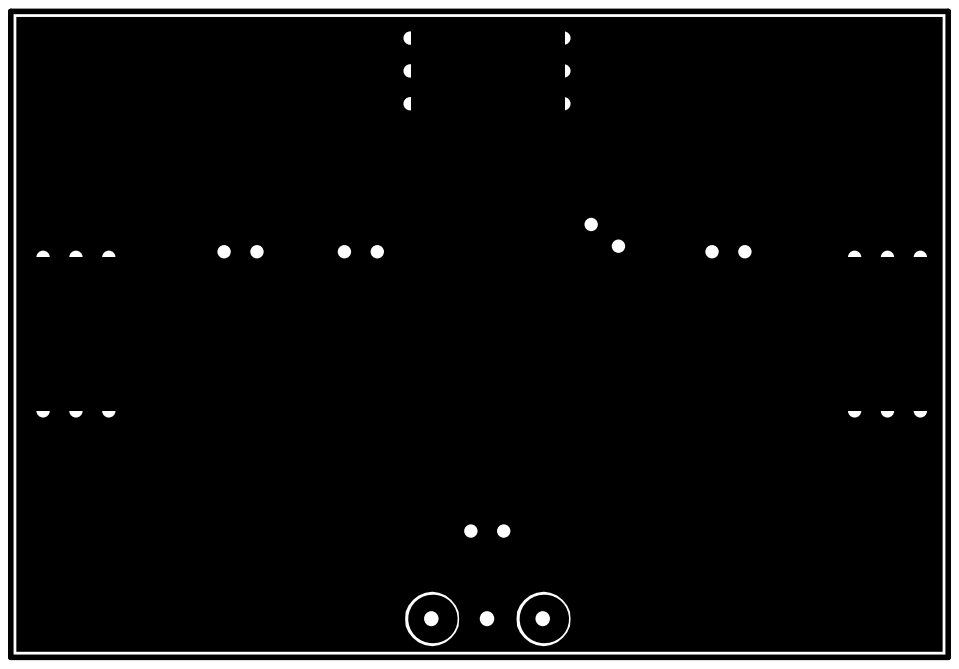
[picture p88: page 2]
