akukulanski/RF_Switch_3GHz/(list of files, drawings)

Other design files:
placa/Proyecto3/Medidas.PrjPcb
placa/Proyecto3/Switch.PcbDoc
placa/Proyecto3/Switch.PcbLib
placa/Proyecto3/Switch.SchDoc
placa/Proyecto3/Switch.SchLib
