akukulanski/RF_Switch_3GHz/placa/polarización/placa-polarizacion.kicad_pcb

## KiCad design placa/polarización/placa-polarizacion.kicad_pcb (2016-09-21)

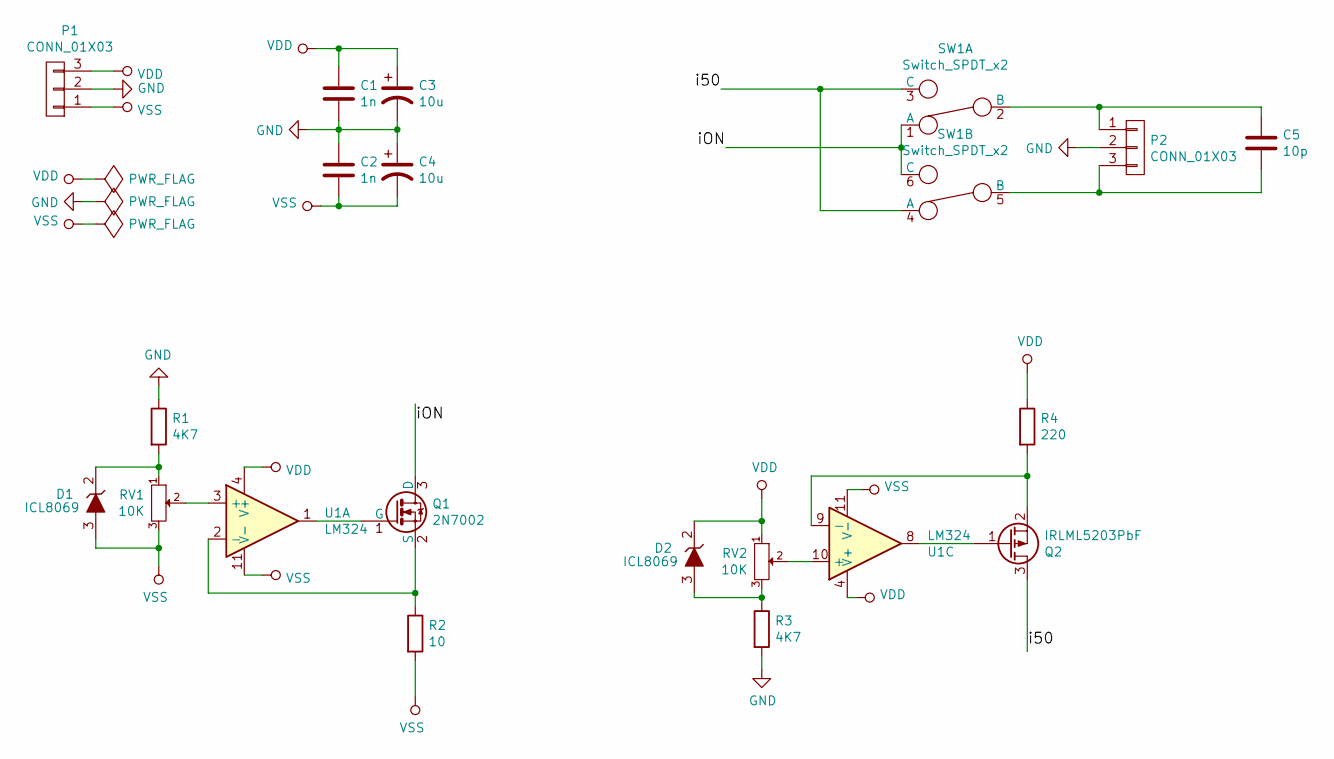
[picture p89: schematic placa-polarizacion.sch]

Parts:
C1, C2: 1n; C_Disc_D3_P2.5
C3, C4: 10u; C_Radial_D5_L11_P2
C5: 10p; C_Disc_D3_P2.5
D1, D2: ICL8069; TO-92_Inline_Narrow_Oval
P1, P2: CONN_01X03; Pin_Header_Angled_1x03
Q1: 2N7002; SOT-23
Q2: IRLML5203PbF; SOT-23
R1, R3: 4K7; Resistor_Horizontal_RM10mm
R2: 10; Resistor_Horizontal_RM10mm
R4: 220; Resistor_Horizontal_RM10mm
RV1, RV2: 10K; Potentiometer_Trimmer-Suntan-TSR-3386C
SW1: Switch_SPDT_x2; pulsador-doble-inversor-con-retencion
U1: LM324; DIP-14_W7.62mm_LongPads

Connections:
/i50: Q2.3 (D), SW1.3 (C), SW1.4 (A)
/iON: Q1.3 (D), SW1.1 (A), SW1.6 (C)
GND: C1.2, C2.1, C3.2, C4.1, P1.2, P2.2, R1.1, R3.2
unnamed: C5.1, P2.1, SW1.2 (B)
unnamed: C5.2, P2.3, SW1.5 (B)
unnamed: D1.2 (Z+), R1.2, RV1.1
unnamed: D2.3 (Z-), R3.1, RV2.3
unnamed: Q1.1 (G), U1.1
unnamed: Q1.2 (S), R2.1, U1.2 (-)
unnamed: Q2.1 (G), U1.8
unnamed: Q2.2 (S), R4.2, U1.9 (-)
unnamed: RV1.2, U1.3 (+)
unnamed: RV2.2, U1.10 (+)
VDD: C1.1, C3.1, D2.2 (Z+), P1.3, R4.1, RV2.1, U1.4 (V+)
VSS: C2.2, C4.2, D1.3 (Z-), P1.1, R2.2, RV1.3, U1.11 (V-)

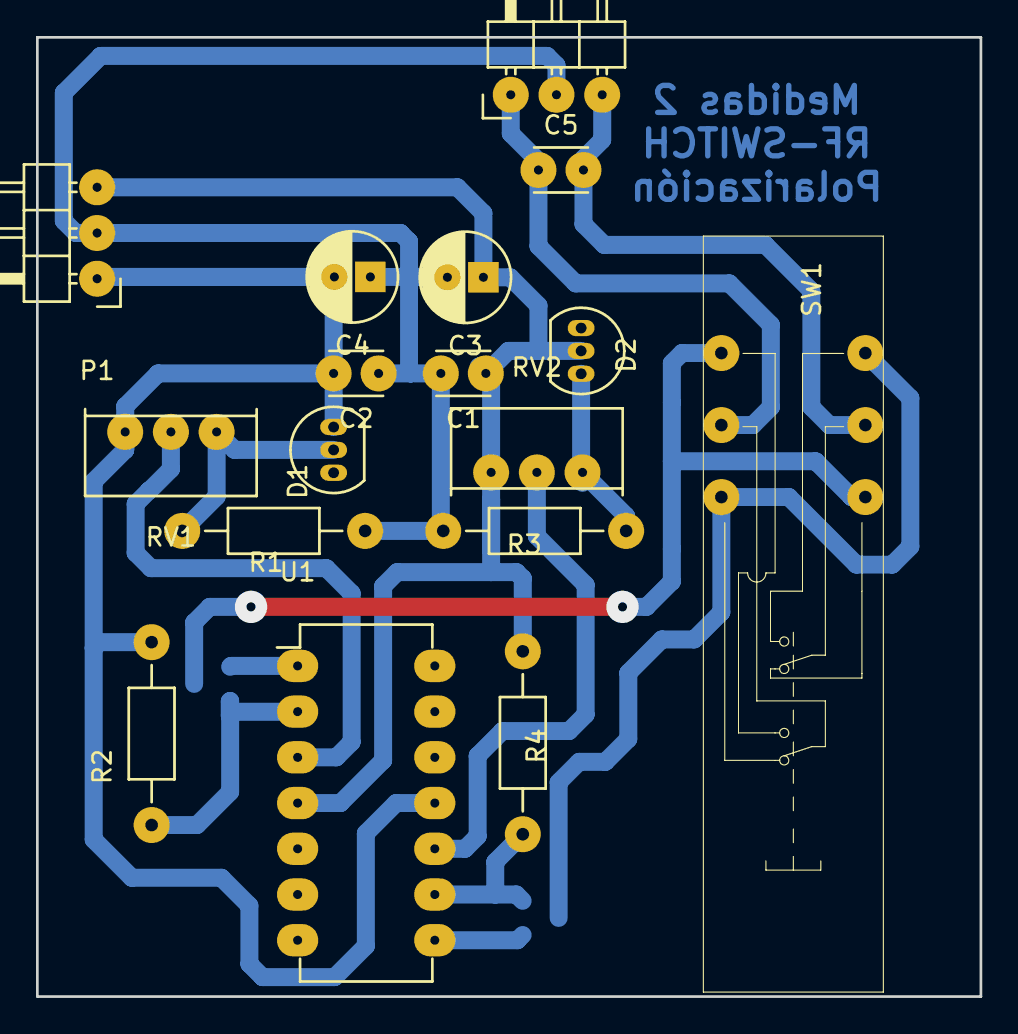
[picture p90: board placa-polarizacion.kicad_pcb from above]

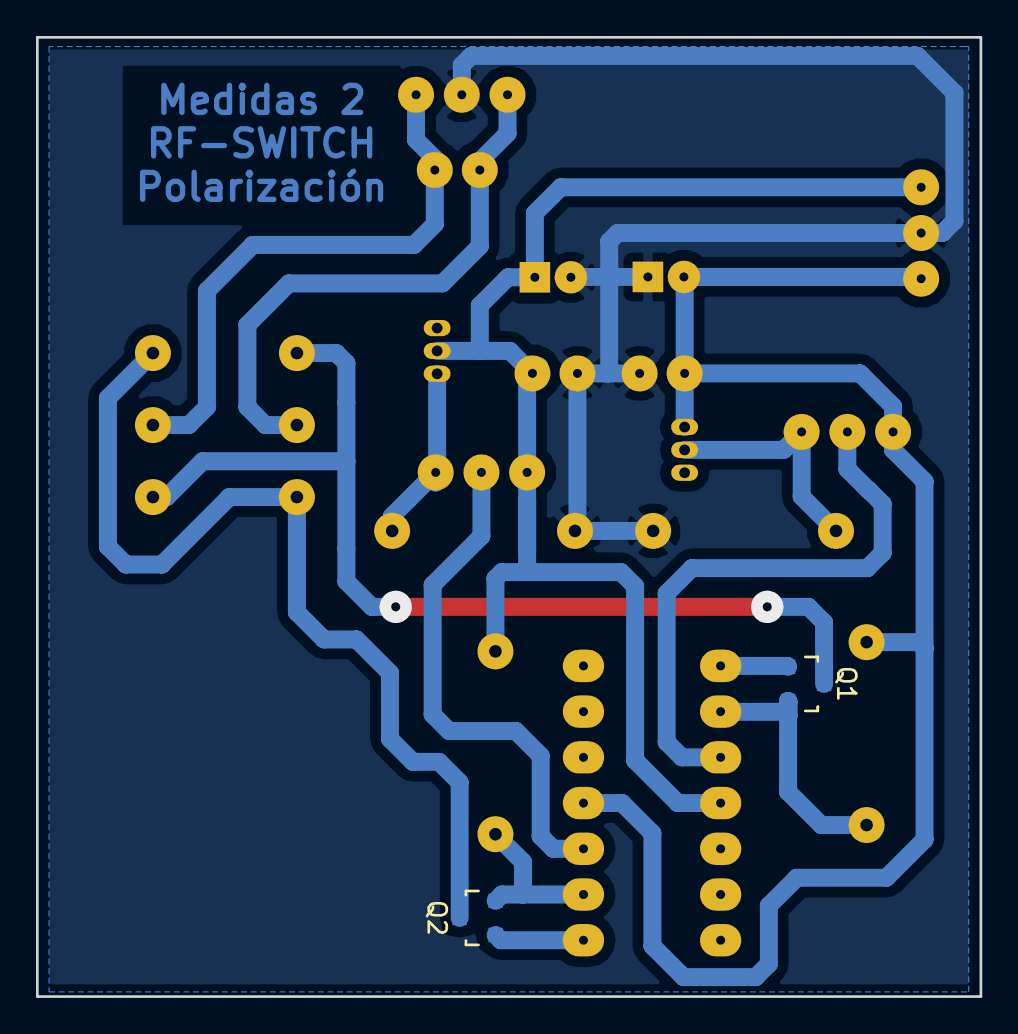
[picture p91: board placa-polarizacion.kicad_pcb from below]

Board: 2 copper layers, 52.4 x 53.3 mm, 19 parts (2 on the bottom side), 15 nets.
