akukulanski/RF_Switch_3GHz/(commit log)

2016-07-14 Se agrega simulación con microstrip y carpeta con gráficos.
    [RFSwitch-Microstrip.sch, s11_sinM.csv, s21_sinM.csv, s31_sinM.csv, s33_sinM.csv, s41_sinM.csv]
2016-07-14 Se agregan los gráficos con Microstrip
    [RFSwitch-Microstrip.sch]
2016-08-08 Se empieza la ppt para el 13-08
2016-09-06 Simulación con 2 choques en vez de R560 (Da todo igual). Circuito de Polarización en TINA (revisar. Falta poner alguna referencia de tensión)
    [RFSwitch-Microstrip-choque.sch]
2016-09-06 nada! pruebo que funcione integración con slack
    [RFSwitch-Microstrip.sch]
2016-09-07 agrego archivo con ref de tensión + potes
2016-09-08 Ancho de pista
2016-09-08 renombre de archivo
2016-09-15 Circuito en Altium (versión a fabricar) + PDFs a escala
    [Medidas.PrjPcb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]
2016-09-20 placa polarización, primer commit
    [placa-polarizacion.kicad_pcb, placa-polarizacion.sch]
2016-09-21 Revision de la placa
    [placa-polarizacion.kicad_pcb]
2016-10-18 Resultados primera medición
    [TRACE097.CSV, TRACE098.CSV, TRACE099.CSV, TRACE100.CSV, TRACE101.CSV, TRACE104.CSV, TRACE105.CSV, TRACE109.CSV]
2017-12-20 entrega de informes, poster, etc.
